allenrobberson/smart-sensor-battery-pack/README.md

# Smart Sensor Battery Pack (18350 / 18650 / 21700 / universal)

A small battery board for a Seeed XIAO microcontroller and an SHTC3 temperature and humidity sensor, for building wireless sensors that run on a single lithium-ion cell. The XIAO plugs into sockets on the front, and the cell sits in a holder on the back.

This is a fork of [FeatureNAB/smart-sensor-battery-pack](https://github.com/FeatureNAB/smart-sensor-battery-pack). It adds two larger battery sizes (18650 and 21700), a **universal board** that takes any of the three holders, a few protection and power improvements, and ready-to-use ESPHome firmware for Home Assistant. All the boards share the same circuit and front-side layout. The full list of changes is under [Changes from the original design](#changes-from-the-original-design).

**Downloads:** each board option (18350, 18650, 21700, universal) comes as one zip on the [Releases page](https://github.com/allenrobberson/smart-sensor-battery-pack/releases). Each zip has the Gerbers, the JLCPCB BOM and placement files, the case STLs, the firmware and a KiCad project that opens on its own.

> **U6 rotation fix (12 November 2026):** placement (CPL) files downloaded before this date have U6 (CSD85301Q2) at 180°; the correct angle is 90°. Use the v1.0 release files. If you already ordered with the old files, ask JLCPCB to rotate U6 to 90° (see [the rotation note](#assembled-by-jlcpcb-bom-and-placement-files)).

The original design, with the build, design theory and assembly, is explained in this video:

Watch the video (https://www.youtube.com/watch?v=-wEKOhVZ0NM)

## Thank you
A big thank you to **FeatureNAB** for designing this board and sharing it openly, along with the video that explains how and why it works. The charging, protection and sensor-isolation design, the compact layout, and the KiCad project are all their work. This fork only builds on that foundation. If you find this useful, please watch and support the [original video](https://www.youtube.com/watch?v=-wEKOhVZ0NM) and [repository](https://github.com/FeatureNAB/smart-sensor-battery-pack).

## Changes from the original design
**New board sizes**
- **18650 board** (`variants/18650/`): Keystone 1042 holder, 23 x 86.25 mm.
- **21700 board** (`variants/21700/`): Keystone 1121 holder (also fits 20700), 24 x 84.55 mm.
- **Universal board** (`variants/universal/`): one 24 x 86.25 mm board with pads and peg holes for the 1096, 1042 *or* 1121 holder, so one design covers 18350, 18650 and 21700. See [Universal](#universal-18350-18650-and-21700-on-one-board).
- **3D-printable case** (`case/`): a base and lid for every board size, including the universal board, with a USB-C window, sensor vents and wall-mount tabs. See [3D-printable case](#3d-printable-case).
- **Variant generator** (`tools/make_variant.py`): rebuilds the larger boards from the 18350 master after any change, swaps the holder, resizes the outline and checks that the holder's holes clear existing copper.

**Circuit changes (all boards)**

| Part | Original | This fork | Why |
|---|---|---|-----|
| Q2 (new) | — | AO3401A P-MOSFET in the battery + line | Protects everything if the cell is inserted backwards |
| U4 regulator | TPS7A05 (200 mA) | RT9080-33GJ5 (600 mA, 2 µA quiescent) | The ESP32-C6 draws up to 354 mA when Wi-Fi transmits; same footprint and pinout |
| C3 (3.3 V cap) | 2.2 µF | 10 µF | Absorbs Wi-Fi current bursts |
| R2 (charger TS) | 10 kΩ fixed resistor | 10 kΩ NTC thermistor, moved away from the charger | Stops charging when too cold or hot; the fixed resistor disabled this |
| R1 (charge current) | 1.2 kΩ (450 mA) | 18350: unchanged. 18650 and 21700: 910 Ω (about 590 mA). Universal: 1 kΩ (about 540 mA) | Larger cells finish charging inside the charger's 10-hour safety timer |
| U1 (schematic) | XIAO nRF52840 | XIAO ESP32-C6 | Matches the firmware; the sockets are the same |

The 18350 board keeps its original size and front layout; Q2 and the moved thermistor fit in free space in the top-right corner.

**Firmware and Home Assistant (new)**
- **ESPHome config** for the XIAO ESP32-C6 (`firmware/`) with deep sleep, sensor power sequencing, internal I2C pull-ups disabled and pins released before sleep, so the sensor is never powered through its data lines.
- **Home Assistant package** (`homeassistant/`) adding a "stay awake" toggle for over-the-air updates, plus a secrets template.

**Manufacturing files (new)**
- **Gerber zips** for all four boards (18350, 18650, 21700, universal) in `gerbers/`, generated by `tools/make_gerbers.py` and checked for shorts and broken connections.
- **JLCPCB assembly files** (BOM with LCSC part numbers, and placement files) in `assembly/`; the schematics now carry LCSC numbers for the new parts.

**Documentation**
- **I2C note corrected:** the original note said pull-ups were missing. R9 and R10 are already in the design, on the switched sensor rail.
- **Points from the original project's [issue #1](https://github.com/FeatureNAB/smart-sensor-battery-pack/issues/1) ("Missing Pull Up Resistor"):**
  - *Pull-ups on the switched rail (3V_SW) vs. 3V3:* kept on 3V_SW on purpose. Pull-ups on the always-on 3V3 would push current into the SHTC3 through SDA/SCL while its supply is off (phantom powering). On 3V_SW, the pull-ups and the sensor are switched on and off together.
  - *"The sensor has to be powered before the bus starts":* the firmware switches the sensor rail on at boot priority 1200, before I2C sets up (priority 1000), and waits 5 ms so the sensors are ready. No extra YAML is needed.
  - *"Use the internal pull-ups instead":* not used. The ESP32-C6's internal pull-ups are about 45 kΩ, too weak to be reliable, and they would phantom-power the sensor during sleep. They are disabled.
  - *Pull-up current:* none while the bus is idle (I2C is open-drain), and none at all while the rail is off.
  - *Measured 380 µA asleep and a 3.45 s wake:* the firmware now sleeps 2 s after Home Assistant connects instead of staying awake a fixed 20 s, so a typical wake is about 3–6 s and uses roughly a quarter of the energy. See [Sleep current](#sleep-current) for how to measure.
  - *Static IP slower for one tester:* the config now says to measure before relying on a static IP.
  - *Edge.Cuts DRC errors:* the outlines of all three boards here are closed (checked: no open ends).
  - *Larger + / − battery marks:* the holder footprints have small + and − marks on the back silkscreen. Reverse-battery protection (Q2) also protects the board if a cell goes in backwards.
- **README rewritten:** board descriptions, comparison images, setup steps and known limitations.

## Quick start
Here's everything you need to build one, in order:

1. **Pick a board:** 18350 (smallest), 18650 or 21700 (longest runtime), or the universal board if you want to choose the cell later. See [The board designs](#the-board-designs).
2. **Order the board:** upload that board's Gerber zip from [`gerbers/`](gerbers) to JLCPCB. Optionally add assembly with the matching BOM and placement files from [`assembly/`](assembly); see [Ordering boards](#ordering-boards-gerber-files).
3. **Buy the parts that aren't on the board order:**
   - The **battery holder** for your size, from DigiKey (see [Battery holders](#battery-holders)).
   - A **Seeed XIAO ESP32-C6** ([product wiki](https://wiki.seeedstudio.com/xiao_esp32c6_getting_started)).
   - A **lithium-ion cell** (see [Batteries](#batteries)).
4. **Solder the holder, then check the board** before inserting a cell (see [Assembly and first power-up](#assembly-and-first-power-up)).
5. **Flash the firmware and add the sensor to Home Assistant** (see [Firmware](#firmware-esphome-xiao-esp32-c6)).
6. **Optionally plug in a second sensor** (see [Adding other sensors](#adding-other-sensors)).

## What the board does
- **Microcontroller:** made for a Seeed **XIAO ESP32-C6**. The board uses D2 (GPIO2) for battery voltage, D4/D5 (GPIO22/23) for I2C and D10 (GPIO18) to switch the sensor power.
- **Charging:** a BQ21040 charges the cell from the XIAO's USB 5 V, and an LED shows charge status. R1 sets the charge current: 450 mA on the 18350 board and about 590 mA on the 18650 and 21700 boards, so a full charge fits inside the charger's 10-hour safety timer.
- **Battery temperature:** a 10 kΩ NTC thermistor (R2, Murata NCP15XH103F03RC) on the charger's TS pin stops charging when the board is too cold or too hot for lithium-ion. It sits in the corner furthest from the charger so the charger's own heat doesn't trip it.
- **Reverse-battery protection:** a P-channel MOSFET (Q2, AO3401A) in series with the cell's + terminal, with its gate on the cell's − terminal. A correctly inserted cell turns it fully on in both directions, for charging and discharging. A reversed cell leaves it off, and its body diode blocks the current.
- **Cell protection:** a BQ29700 protector with a CSD85301Q2 dual MOSFET guards against over-charge, over-discharge and over-current.
- **Power:** an RT9080-33GJ5 regulator (600 mA, 2 µA quiescent current) supplies 3.3 V to the XIAO. That covers the ESP32-C6's Wi-Fi transmit peaks (up to 354 mA at full power) with headroom, and a 10 µF capacitor (C3) on 3.3 V absorbs the bursts.
- **Battery monitoring:** a 5.1 MΩ / 5.1 MΩ divider brings the battery voltage to a XIAO analog pin (BATT_SENSE) and draws about 0.4 µA.
- **Switched sensor power:** a P-channel MOSFET (Q1, AO3401A) lets the XIAO turn the sensor rail (3V_SW) off between readings. The I2C pull-ups (R9, R10) are on that rail too, so nothing on the sensor side draws current while the XIAO sleeps.
- **Sensor:** an SHTC3 sits on a slotted tab at the bottom edge, thermally isolated from the rest of the board, with an extra socket for a plug-in I2C sensor.

## The board designs
All the boards share the same schematic and the same front-side parts and routing. Only the holder on the back, the board outline and the two battery traces change. The extra length is added at the BAT+ end, so the sensor tab stays where it is.

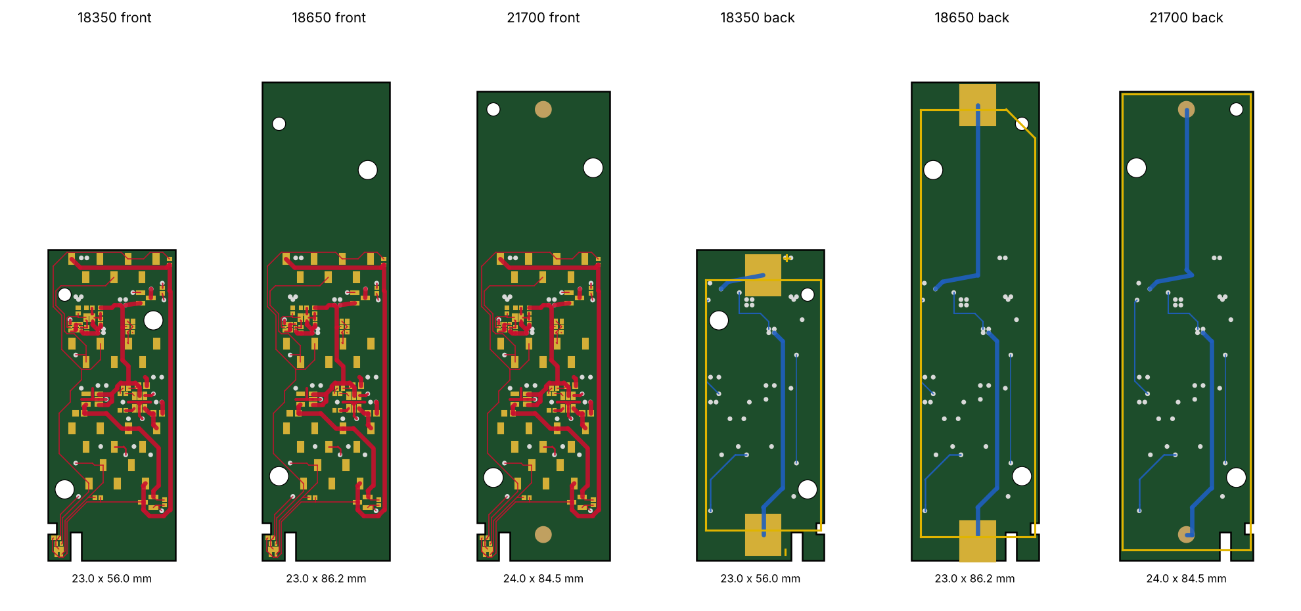
[picture p1: docs/images/board_comparison.png]
All three boards, front and back


| Cell | Holder (back side) | Holder mounting | Board size | KiCad project |
|---|---|---|---|---|
| 18350 | Keystone 1096 | Surface mount | 23 x 56 mm | repository root (original design) |
| 18650 | Keystone 1042 | Surface mount | 23 x 86.25 mm | `variants/18650/` |
| 21700 | Keystone 1121 (fits 20700 and 21700) | Through-hole solder lugs | 24 x 84.55 mm | `variants/21700/` |
| **Universal** | Keystone 1096, 1042 **or** 1121 | SMD pads + lug holes for all three | 24 x 86.25 mm | `variants/universal/` |

### 18350
The original, most compact design. The Keystone 1096 holder covers the whole back of the board.

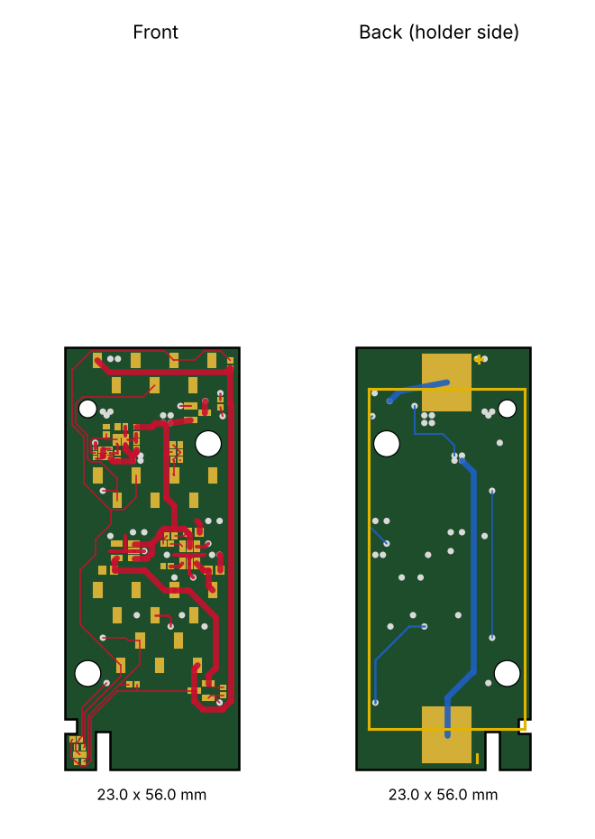
[picture p2: docs/images/board_18350.png]
18350 board, front and back


### 18650
The same board stretched to 86.25 mm for a Keystone 1042 holder. The holder's locating holes are placed to clear all existing copper. The BAT- pad overhangs the bottom edge by 0.25 mm, which DRC will flag; the original board overhangs its BAT+ pad by 0.95 mm in the same way.

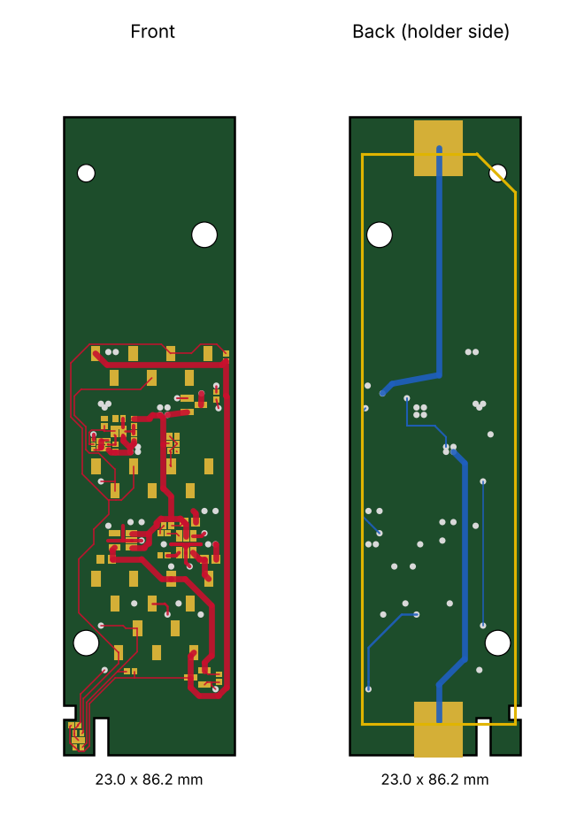
[picture p3: docs/images/board_18650.png]
18650 board, front and back


### 21700
Uses a Keystone 1121 holder. The holder is 23.06 mm wide, so the board is 1 mm wider than the original, with the extra width on the right so the sensor tab is unchanged. The holder's solder lugs go through the board and are soldered from the front.

The footprint was drawn from Keystone drawing 1121 rev A. The lug holes are drilled 1.7 mm instead of the drawing's 1.32 mm, because the drawing gives the lug pin itself as 1.57 mm. Check a lug against the hole before ordering.

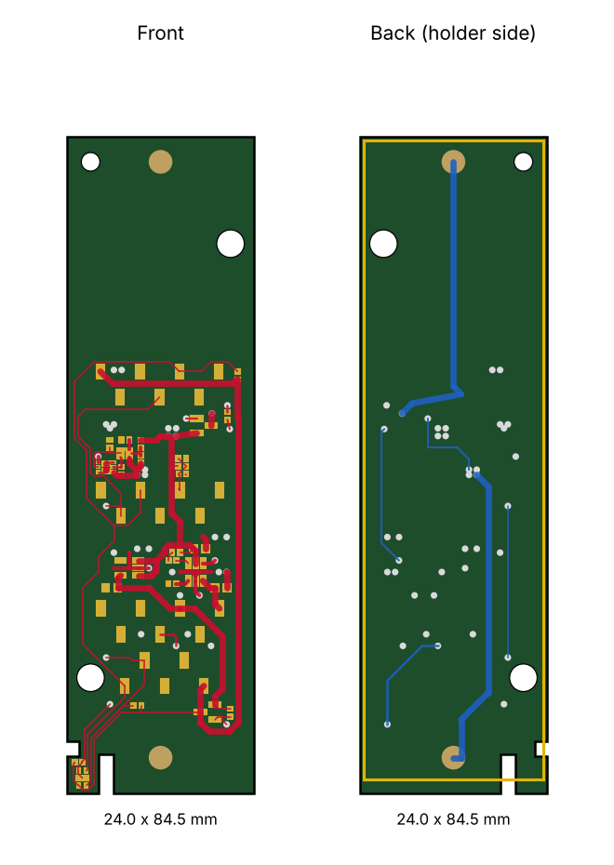
[picture p4: docs/images/board_21700.png]
21700 board, front and back


### Universal (18350, 18650 and 21700 on one board)
One board that takes any of the three holders, so you can order a single design and choose the cell later. It is the 21700 board lengthened to 86.25 mm (the 1042's length), 24 mm wide.

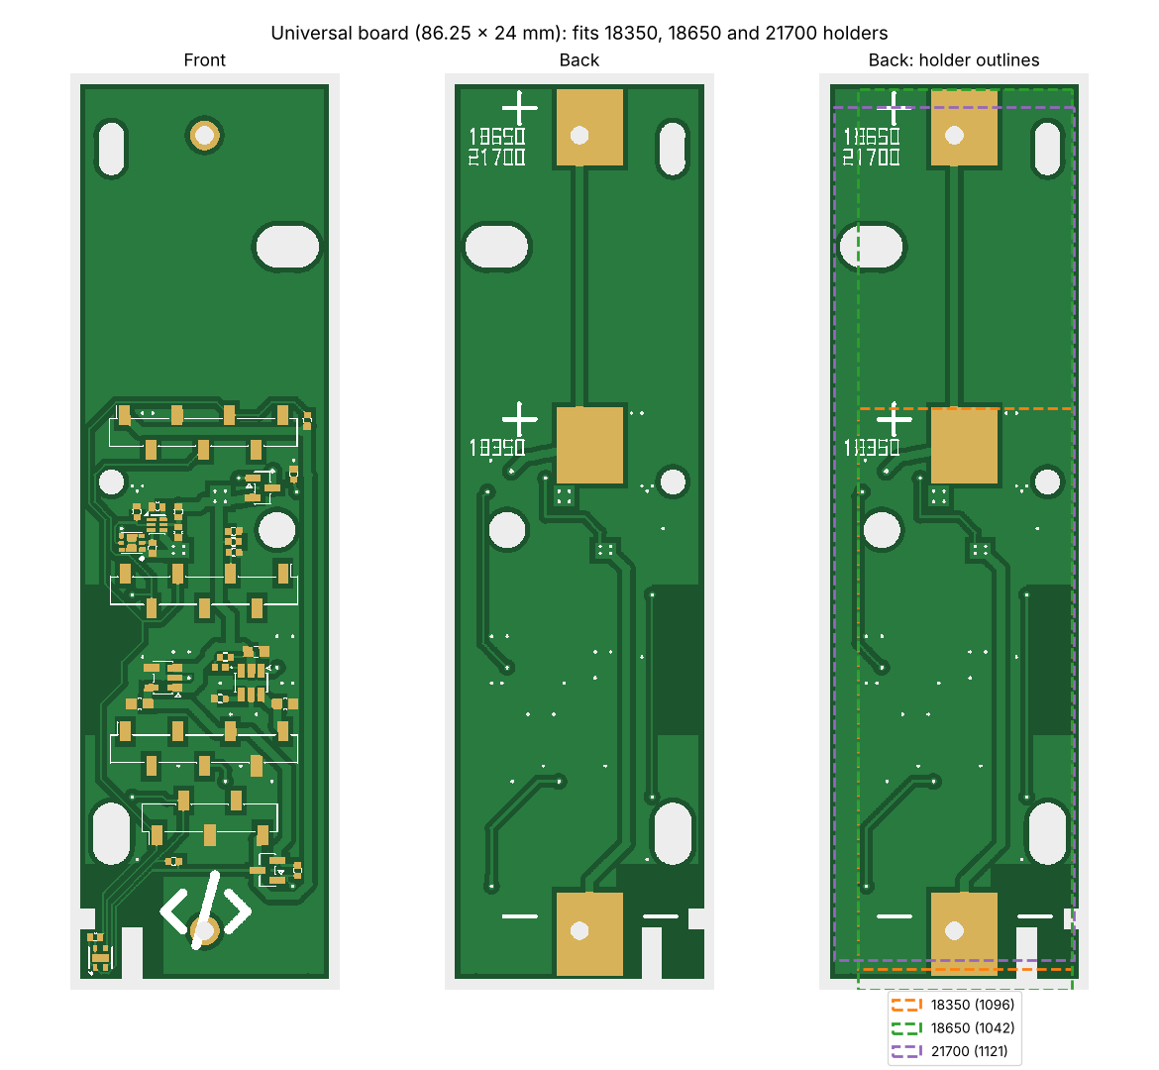
[picture p5: docs/images/board_universal.png]
Universal board: front, back, and where each holder sits


- **BAT- end (bottom):** one larger SMD pad covers both the 1096 and the 1042 contact, with the 1121's plated lug hole in the middle of it. All three holders' − contacts land here.
- **BAT+ end (top):** the + pad for the 1042 (18650) sits at the top edge, with the 1121's (21700) lug hole inside it. A second + pad for the 1096 (18350) sits 30.7 mm further down. The two are joined by the BAT+ trace on the back, under solder mask, so there is no long strip of bare battery copper. The back silkscreen shows which + pad belongs to which cell (`18650 21700` and `18350`), plus large + and − marks.
- **Locating holes:** every holder's pegs have a hole. Where two holders' pegs overlap, the holes are merged into slots: one small and one large slot on the left, and one large slot on the right. All holes keep at least 0.3 mm from copper.
- **Charge current:** R1 is **1 kΩ (about 540 mA)**, LCSC C11702, a basic part. That's under 0.5C for a 1100 mAh 18350 and still charges a 4500 mAh 21700 inside the charger's 10-hour safety timer. With a 5000 mAh cell charged from empty, the timer can stop the charge just before it finishes; unplugging and replugging USB restarts it. For an 18650/21700-only build, you can fit 910 Ω (C44933) instead.
- **Soldering the holder:** for the 1096 or 1042, solder the contacts to the pads; the small lug holes under them just fill with solder. For the 1121, solder its lugs from the front as on the 21700 board. Only fit one holder.

The front side, parts and routing are the same as the other three boards, so the same firmware and BOM apply. The only BOM difference is R1. The board and its files were made by `tools/make_universal.py`.

**What has been checked:** the Gerbers have no shorts or broken nets; every hole and slot keeps at least 0.3 mm from other-net copper; no copper is within 0.25 mm of the board edge; JLCPCB accepted the files, matched all 19 parts and showed the slots correctly; and every part's rotation was checked in JLCPCB's placement preview (pin-1 marks and leads on pads). **Not yet checked:** a KiCad DRC run (open `variants/universal/` in KiCad, press B to refill zones, then run DRC) and a physical test-fit of each holder. Check the peg slots against a real holder before ordering in quantity.

## 3D-printable case
A two-part case (base + lid) for every board, in [`case/stl/`](case/stl). Details and print settings are in [`case/README.md`](case/README.md).

| Board | Print |
|---|---|
| 18350 | [`case-18350-base.stl`](case/stl/case-18350-base.stl) + [`case-18350-lid.stl`](case/stl/case-18350-lid.stl) |
| 18650 | [`case-18650-base.stl`](case/stl/case-18650-base.stl) + [`case-18650-lid.stl`](case/stl/case-18650-lid.stl) |
| 21700 | [`case-21700-base.stl`](case/stl/case-21700-base.stl) + [`case-21700-lid.stl`](case/stl/case-21700-lid.stl) |
| Universal | the base for the holder you fitted ([`18350`](case/stl/case-universal-18350-base.stl), [`18650`](case/stl/case-universal-18650-base.stl) or [`21700`](case/stl/case-universal-21700-base.stl)) + [`case-universal-lid.stl`](case/stl/case-universal-lid.stl) |

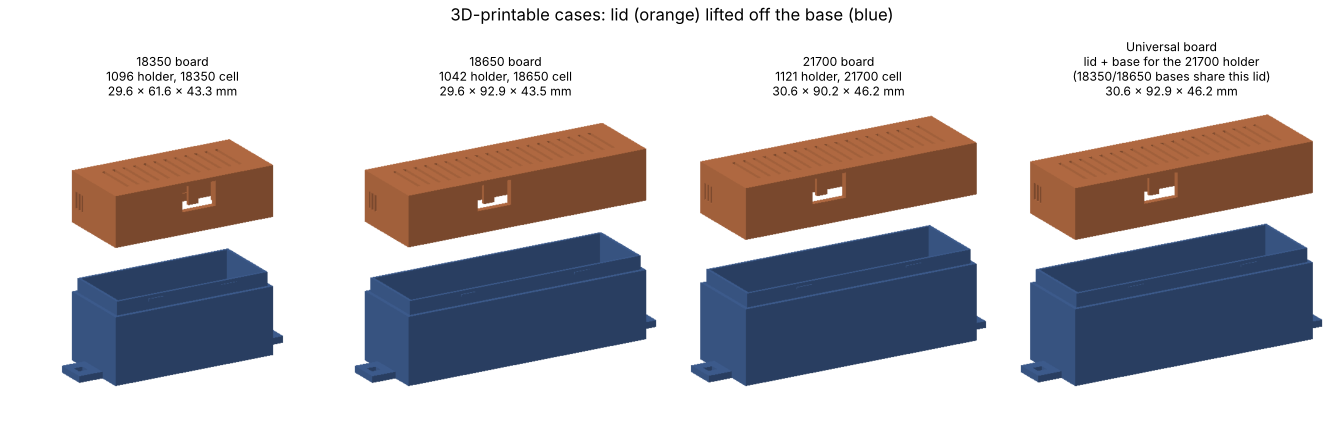
[picture p6: case/images/cases-overview.png]
All four cases, lid lifted off the base


More views of each case (exploded, base, lid from below, assembled) and cut-away fit checks are in [`case/images/`](case/images).

- **Base:** the board drops in battery-side down and rests on ribs under the holder's end walls.
- **Lid:** clicks onto a lip on the base; small fingers stop just above the board's edges so it can't move.
- **USB-C window:** lined up with the XIAO's USB-C port, so you can charge and flash without opening the case.
- **Vents** next to the SHTC3 sensor tab and across the roof, so the sensor reads room air; **wall-mount tabs** on both ends.
- **Checked:** the generator checks every case against the board, holder, cell, every part, the XIAO and the USB-C plug path, and checks that the STLs are watertight. The case hasn't been test-printed yet. If your sockets or headers are a different height, change the values at the top of [`tools/make_case.py`](tools/make_case.py) and run it again.

## Ordering boards (Gerber files)
Ready-to-upload Gerber zips for all four boards are in [`gerbers/`](gerbers):

| Board | File | Size |
|---|---|---|
| 18350 | [`gerbers/SSB-18350-gerbers.zip`](gerbers/SSB-18350-gerbers.zip) | 23 x 56 mm |
| 18650 | [`gerbers/SSB-18650-gerbers.zip`](gerbers/SSB-18650-gerbers.zip) | 23 x 86.25 mm |
| 21700 | [`gerbers/SSB-21700-gerbers.zip`](gerbers/SSB-21700-gerbers.zip) | 24 x 84.55 mm |
| Universal | [`gerbers/SSB-UNIVERSAL-gerbers.zip`](gerbers/SSB-UNIVERSAL-gerbers.zip) | 24 x 86.25 mm |

**To order at JLCPCB:** upload a zip on the quote page and keep the defaults: 2 layers, 1.6 mm FR-4, 1 oz copper. Choose any solder-mask colour. If you want JLCPCB to assemble the parts, pick **LeadFree HASL** so the cheaper Economic assembly is allowed (see [Tested JLCPCB order settings](#tested-jlcpcb-order-settings-november-2026)). Each zip holds both copper layers, solder mask, paste, silkscreen, the board outline, and plated and non-plated drill files.

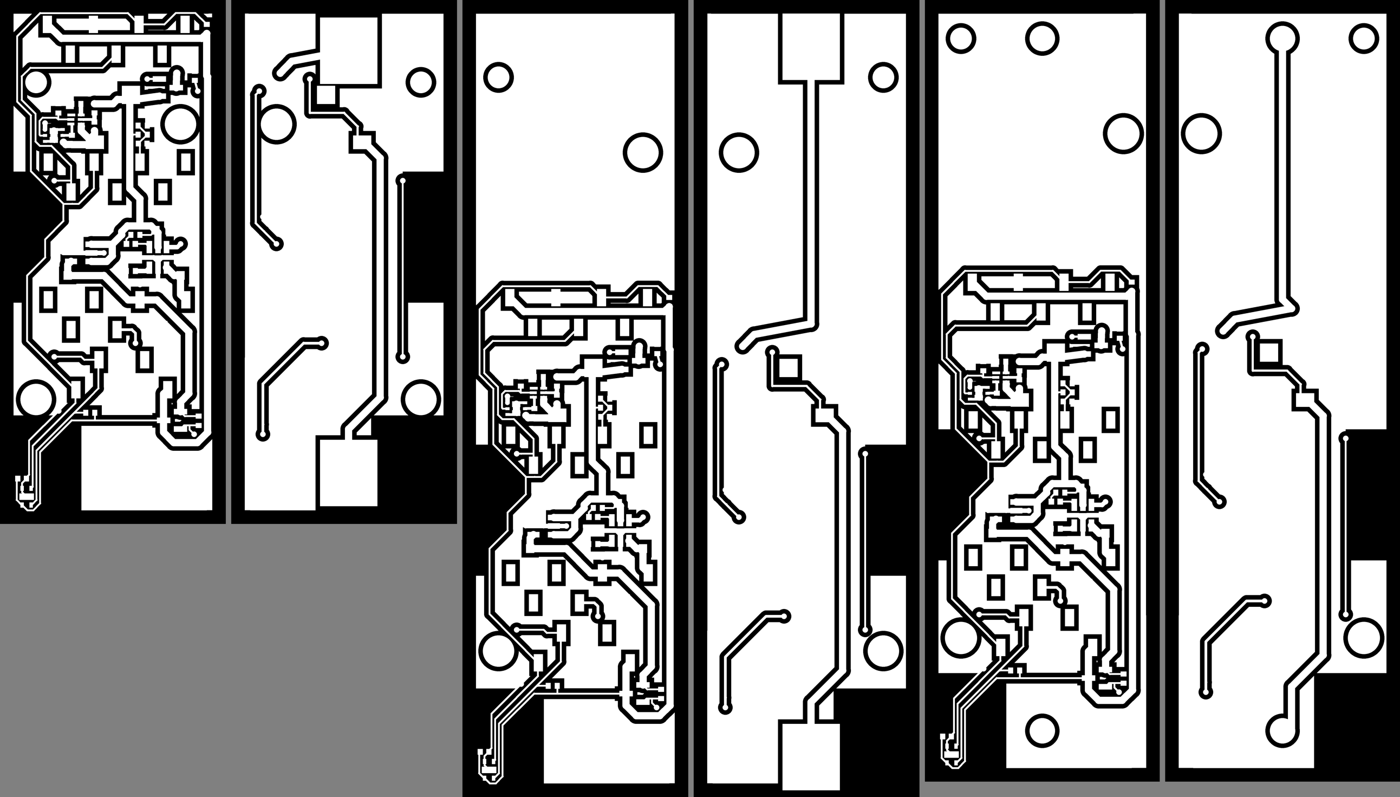
[picture p7: docs/images/gerber_copper.png]
Copper layers of all three boards


*Copper as written to the Gerbers (white = copper), front and back for 18350, 18650 and 21700. The back views are mirrored as if the board were flipped over.*

### Assembled by JLCPCB (BOM and placement files)
To have JLCPCB solder the parts, choose **PCB Assembly** (top side) on the quote page, then upload the BOM and placement (CPL) files for the same board from [`assembly/`](assembly):

| Board | BOM | Placement |
|---|-----|---|
| 18350 | [`SSB-18350-BOM.csv`](assembly/SSB-18350-BOM.csv) | [`SSB-18350-CPL.csv`](assembly/SSB-18350-CPL.csv) |
| 18650 | [`SSB-18650-BOM.csv`](assembly/SSB-18650-BOM.csv) | [`SSB-18650-CPL.csv`](assembly/SSB-18650-CPL.csv) |
| 21700 | [`SSB-21700-BOM.csv`](assembly/SSB-21700-BOM.csv) | [`SSB-21700-CPL.csv`](assembly/SSB-21700-CPL.csv) |
| Universal | [`SSB-UNIVERSAL-BOM.csv`](assembly/SSB-UNIVERSAL-BOM.csv) | [`SSB-UNIVERSAL-CPL.csv`](assembly/SSB-UNIVERSAL-CPL.csv) |

Every part except the battery holder uses a JLCPCB/LCSC part number:

| Part | Designator | LCSC # |
|---|---|---|
| Charger BQ21040DBVR | U2 | C202311 |
| Protector BQ29700DSER | U5 | C183096 |
| Dual MOSFET CSD85301Q2 | U6 | C544396 |
| Regulator RT9080-33GJ5 | U4 | C841192 |
| P-MOSFET AO3401A | Q1, Q2 | C15127 |
| SHTC3 sensor | U7 | C194656 |
| 10 kΩ NTC (Murata NCP15XH103F03RC) | R2 | C77131 |
| 10 µF 0603 | C3 | C19702 (basic part) |
| 2.2 µF 0603 | C1, C2 | C23630 (basic part) |
| 100 nF 0402 | C4, C5, C6 | C1525 |
| Charge-current resistor | R1 | 1.2 kΩ C25862 (18350), 910 Ω C44933 (18650, 21700) |
| Other 0402 resistors, LED | R3–R12, D1 | see the BOM files |
| XIAO sockets 1x7 / 1x5 SMD | J1, J2, J3 / J5 | C42379199 / C42379198 |

Things to know before ordering assembly:
- **Battery holder:** BT1 is not in the BOM, so buy it separately and solder it yourself (see [Battery holders](#battery-holders) below).
- **Extended parts:** most of the ICs are JLCPCB "extended" parts, which carry a small one-time loading fee each. Stock changes, so the quote page will flag anything that has run out.
- **Rotations are already corrected:** the CPL files include JLCPCB's zero-angle offsets for the sockets, SOT-23, SOT-23-5, SOT-23-6, SHTC3 and CSD85301Q2 parts (see `ROTATION_FIX` in `tools/make_jlc_bom.py`). Every part was checked in JLCPCB's placement preview: each IC's pin-1 marker sits at the board's pin-1 mark and its leads on the pads. All four boards share identical front-side pads and placement data, so the check covers all of them. **U6 (CSD85301Q2) needs 90°, not 180°:** JLCPCB's library footprint for C544396 has the pins in rows with pin 1 bottom-left, while the KiCad footprint has them in columns. The first CPL files (used for the November 2026 order of the 18350/18650/21700 boards) had U6 at 180°, which turns the part 90° on its pads. This was fixed on 12 November 2026; if you downloaded the assembly files before then, download them again. **If you already placed an order with the old CPL file,** message JLCPCB (through the order's File Review or support chat) before assembly and ask them to place U6 (CSD85301Q2, C544396) at 90° so that pin 1 sits at the silkscreen dot. They can correct the rotation on an order that is still in review.
- **The XIAO:** it plugs into the sockets and isn't part of the order.

#### Tested JLCPCB order settings (November 2026)
The 18350, 18650 and 21700 Gerbers and BOMs are exactly the ones uploaded for a real order of those three boards. Their CPL (placement) files have since had one fix: U6 is now at 90° instead of 180° (see the rotation note above). The universal board's files were uploaded with the same settings and quoted at **$73.82** for 5 assembled boards ($5.10 PCB + $68.72 assembly, including $0.91 nitrogen reflow); all 19 parts matched and were in stock, and JLCPCB's preview showed its slotted holes correctly. These settings went through without errors:

| Setting | Value | Why |
|---|---|-----|
| Surface finish | **LeadFree HASL** | Economic PCBA does not accept OSP. Lead-free HASL costs about $1.10 more, but it unlocks the much cheaper assembly tier |
| PCBA type | **Economic** | Setup fee about $8 instead of about $26, a $1.55 stencil instead of $8.27, and no per-feeder loading fees (only a ~$3 fee per extended part) |
| PCB qty / PCBA qty | 5 / 5 | Economic PCBA allows 2 to 50 assembled boards |
| Assembly side | Top | BT1 on the back is soldered by hand |
| Tooling holes | Added by JLCPCB | Default |
| Product description | Sensor\Controller\Precision Instrument / Temperature Sensor | Needed for customs |
| Assembly remark | (optional) "Please confirm pin 1 of U6 (CSD85301Q2, C544396) is at the silkscreen dot, bottom-right of U6." | A second check on the one part whose rotation had to be corrected. The **Assembly Remark** box doesn't always appear; if it's missing, raise it during **File Review** in your order history. Don't use the 200-character **PCB Remark** box, which goes to the board factory, not assembly. |

Quoted price for 5 assembled boards, before shipping and coupons:

| Board | PCB | Assembly (Economic) | Total |
|---|-----|---|---|
| 18350 | $5.10 | $68.74 | **$73.84** |
| 18650 | $5.10 | $71.84 | **$76.94** |
| 21700 | $5.10 | $71.84 | **$76.94** |

Assembly breakdown (Economic PCBA, 5 boards):

| Item | 18350 | 18650 | 21700 |
|---|---|---|---|
| Setup fee | $8.24 | $8.24 | $8.24 |
| Stencil | $1.55 | $1.55 | $1.55 |
| Components (19 BOM lines) | $26.09 | $26.10 | $26.10 |
| Extended components fee | $30.90 | $33.99 | $33.99 |
| SMT assembly | $1.05 | $1.05 | $1.05 |
| Nitrogen reflow | $0.91 | $0.91 | $0.91 |
| **Assembly total** | **$68.74** | **$71.84** | **$71.84** |
| PCB (5 boards, lead-free HASL) | $5.10 | $5.10 | $5.10 |
| **Per order** | **$73.84** | **$76.94** | **$76.94** |
| **Per assembled board** | **$14.77** | **$15.39** | **$15.39** |

Universal board (quoted the same way): $5.10 PCB + $68.72 assembly = **$73.82** for 5 assembled boards ($14.76 each), the same extended-part fees as the 18350.

The 18350 has one fewer extended part than the other two (its R1, C25862, is a basic part), so its fee is lower.

All three boards in one checkout (15 assembled boards), as actually ordered and shipped to the US in November 2026:

| | Cost |
|---|---|
| Merchandise (3 × PCB + PCBA) | $227.72 |
| Shipping (the cart page had estimated $31.69 for UPS Express Saver) | $64.13 |
| US customs duties and taxes | $79.73 |
| Duty and tax disbursement fee | $4.44 |
| **Order total** | **$376.02** (about $25 per assembled board) |

**Budget for more than the cart shows.** The cart's shipping estimate is only a starting point: the shipping charge depends on the method you choose at checkout. US import duties and taxes on the assembled boards came to about 35% of the merchandise total, and JLCPCB charges them at checkout (DDP). Coupons (below) come off the total. Ordering fewer board sizes lowers every line, since each design is a separate PCB + PCBA order.

Not included: the battery holder (BT1, bought separately, see [Battery holders](#battery-holders)), the XIAO ESP32-C6 and the battery.

**Coupons:** JLCPCB uses account coupons rather than codes, and you choose them in the payment step of checkout. New accounts get New User SMT ($10), PCB ($6) and Shipping ($10) coupons, and the [coupon center](https://jlcpcb.com/coupon-center) has more (for example, "PCBA Special Offer" $9/$6). Checking out in the **JLCONE desktop app** unlocks a "JLCONE PCBA $20" coupon for assembly orders over $100, which beats the $10 one for a three-board order. JLCPCB's terms allow one coupon per order, so the checkout page has the final say. Check out all three boards together: separate orders each pay their own shipping (about $27), which costs more than the extra coupons save.

For comparison, the same 18350 order as *Standard* PCBA on OSP came to $96.33.

**Ways to cut the cost further:**
- **Order 2 assembled boards instead of 5.** Most of the assembly cost is per-order fees (setup, extended-part fees), so 2 boards cost only a little less than 5, but the total is still lower if you only need one or two.
- **Order one or two sizes, not all three.** Each design pays its own setup and extended-part fees.
- **Solder the XIAO sockets yourself.** J1–J3 and J5 (C42379199, C42379198) cost about $5.65 in parts per 5-board order, plus two extended-part fees (about $6). Untick them on the BOM page and solder ordinary 2.54 mm female headers.
- **Drop the status LED.** D1 (and its resistor R8) are optional. Unticking D1 saves one extended-part fee.
- **Basic parts were preferred** where they did not change the circuit: R7 (100 kΩ) uses basic part C25741.
- **Order only the universal board** if you haven't decided on a cell size: one design covers all three holders, so you pay one set of setup and extended-part fees.

**Part changes made while ordering:**
- **R1 on the 18650/21700:** C4129882 (910 Ω, 5%) was out of stock, so R1 is now Uniroyal 0402WGF9100TCE, **C44933** (910 Ω, 1%, about 228k in stock). The value and charge current (about 590 mA) are unchanged.
- **R7, all boards:** now C25741 (basic, 1%) instead of C25530 (extended, 5%). Same 100 kΩ value.

### Battery holders
**Note:** the battery holder is the one part JLCPCB does not assemble. It isn't in the BOM, because JLCPCB doesn't reliably stock these Keystone holders and they mount on the back of the board, which would need a second, more expensive assembly side. Order the holder for your board size and solder it yourself after the boards arrive.

Each board is laid out for one specific Keystone holder, and only that part fits its pads and locating holes:

| Board | Holder | Mounting | DigiKey |
|---|---|---|-----|
| 18350 | Keystone **1096** | Surface mount (tabs soldered on the back) | [36-1096-ND](https://www.digikey.com/en/products/detail/keystone-electronics/1096/5057788) |
| 18650 | Keystone **1042** | Surface mount (tabs soldered on the back) | [36-1042-ND](https://www.digikey.com/en/products/detail/keystone-electronics/1042/2745668) |
| 21700 | Keystone **1121** (fits 20700 and 21700) | Through-hole lugs (soldered from the front) | [36-1121-ND](https://www.digikey.com/en/products/detail/keystone-electronics/1121/12751670) |

**Soldering tips**
- **1096 and 1042:** the holder sits on the back. Tack one tab, check the holder is flat with its locating pegs in the holes, then solder the other tab. The tabs are large, so use a hot iron (about 350 °C) and plenty of flux.
- **1121:** push the lugs and pegs through from the back, then solder the two lugs on the front.
- **Polarity:** check it before inserting a cell. The + end of the holder must match the + mark on the board (the BAT+ end, away from the sensor tab). Q2 protects the board if a cell goes in backwards, but double-check anyway.

The files come from [`tools/make_jlc_bom.py`](tools/make_jlc_bom.py), which reads the *LCSC Part no.* field from each schematic and the positions from the board, in the same coordinates as the Gerbers.

**How these were made:** KiCad was not available, so the files were generated by [`tools/make_gerbers.py`](tools/make_gerbers.py) directly from the `.kicad_pcb` files. It fills the copper pours itself: ground copper everywhere, a 0.5 mm gap around every other net and the board edge, and no copper in the keep-out areas. Every copper layer was then rasterized at 0.02 mm and checked automatically. There are no shorts between nets, no broken connections, and every pad, via and trace sits on copper. The check was itself tested by deliberately breaking a trace, which it caught. The differences from a KiCad export are:
- **Solid ground connections:** pads and vias on the ground pour are joined solidly rather than through thermal-relief spokes. Ground pads take a little longer to heat when hand-soldering.
- **Square pad corners:** rounded-rectangle pads are drawn as plain rectangles.
- **Outline-only silkscreen:** part outlines are drawn, but there's no text (reference designators and the logo). Use the board images above while assembling.

If you have KiCad 9, the safer route is still to open each project, press **B** to refill the zones, run DRC, and plot your own Gerbers. To regenerate these files after a design change, run:
```
python3 tools/make_gerbers.py <board.kicad_pcb> <output_dir> --name <prefix>
```

## Before ordering boards
The design changes in this fork (reverse-battery transistor, NTC, new regulator, larger boards) were made by script. They were checked with the clearance, connectivity and Gerber checks described above, but not with KiCad's own DRC, and no board has been built yet. Order a small batch first.

### Known limitations
- **Cell temperature is measured on the board, not on the cell.** The thermistor sits on the front, above the cell, so it reads board temperature. Charging can pause on a hot day once the board passes about 45 °C.
- **A completely flat cell (near 0 V) won't charge.** Q2 needs a couple of volts across the cell to turn on. Cells that low shouldn't be recovered anyway.
- **USB plugged in with a nearly empty cell.** When the XIAO runs from USB, its own regulator also drives 3.3 V. If the cell is below about 3.0 V at that moment, the RT9080's output sits slightly above its input, past its 0.3 V reverse rating. The original design had the same behaviour; it lasts only until the cell charges past 3 V.

## Connectors and pinout
The XIAO plugs into J1 and J2. J3 and J5 are for an optional plug-in sensor.

| Socket | Pin 1 | Pin 2 | Pin 3 | Pin 4 | Pin 5 | Pin 6 | Pin 7 |
|---|---|---|---|---|---|---|---|
| **J1** (XIAO left row) | D0 – free | D1 – free | D2 – BATT_SENSE | D3 – free | D4 – SDA | D5 – SCL | D6 – free |
| **J2** (XIAO right row) | D7 – free | D8 – free | D9 – free | D10 – sensor power (Q1) | 3V3 | GND | 5V (USB) |
| **J3** (sensor socket, top edge) | 3V3 switched | not connected | GND | SCL | SDA | not connected | not connected |
| **J5** (sensor socket, middle) | SDA | SCL | GND | not connected | 3V3 switched |  |  |

- **Switched 3.3 V:** this rail on J3 and J5 is the sensor rail controlled by Q1. It's only powered while the firmware holds D10 (GPIO18) low, so a plug-in sensor is switched off during deep sleep, just like the onboard SHTC3.
- **J3's pin order** (power, unused, GND, SCL, SDA) is the common breakout header order *VIN, 3Vo, GND, SCL, SDA*, so many 5-pin breakouts plug straight in. Always check the header order printed on your breakout first.
- **Free XIAO pins:** D0, D1, D3, D6, D7, D8 and D9 aren't connected to anything on the board, so you can use them for your own additions.

## Batteries
- **Cell type:** use a single **3.7 V lithium-ion cell** of the size your board is built for (18350, 18650, or 20700/21700; on the universal board, the size of the holder you fitted). The board has its own protection (BQ29700) and reverse-battery protection (Q2), so unprotected cells are fine.
- **Cell length:** protected cells are a few millimetres longer and may not fit the holder.
- **Cell source:** buy from a reputable cell manufacturer or a known battery retailer. Avoid unbranded cells with inflated capacity ratings.
- **Charge time:** about 3 hours for a typical 18350, 6–8 hours for an 18650 and up to about 9 hours for a 5000 mAh 21700. The charger's 10-hour safety timer covers all of these.
- **Polarity:** match the cell's + end to the + mark on the holder. Q2 protects the board if a cell goes in backwards, but the cell won't charge or run the board until it's turned around.

## Assembly and first power-up
1. **Solder the board:** solder the battery holder, and anything else you didn't have assembled. The [BOM files](assembly) list every part with its LCSC number, so you can also order them from LCSC and hand-solder.
2. **Check before inserting a cell:** use a multimeter to check there's no short between the holder's + and − pads, or between 3V3 and GND on J2.
3. **First power on USB only:** insert the XIAO, but no cell yet, and plug USB into the XIAO. The charge LED may flicker, because the charger is looking for a battery; that's normal.
4. **Flash the firmware** over USB (see [Firmware](#firmware-esphome-xiao-esp32-c6)).
5. **Insert the cell:** with USB still connected, the charge LED should light while the cell charges and turn off when it's full.
6. **Check the readings:** with USB unplugged, the node should wake, report temperature, humidity and battery voltage, and go back to sleep. The battery voltage in Home Assistant should be within about 0.1 V of a multimeter reading across the cell.

## Adding other sensors
Any 3.3 V I2C sensor breakout can plug into J3 or J5. It shares the bus with the onboard SHTC3 (address 0x70), so its I2C address must not be 0x70. The sensors below all have ESPHome support (platform names checked against the ESPHome docs; each name links to its page), and suit a battery-powered node:

| Sensor | Measures | ESPHome platform | Fit for this board |
|---|---|---|---|
| **SHT40 / SHT45** | Temperature, humidity (more accurate than the SHTC3) | [`sht4x`](https://esphome.io/components/sensor/sht4x.html) | Excellent: fast, microamp current |
| **BME280** | Temperature, humidity, air pressure | [`bme280_i2c`](https://esphome.io/components/sensor/bme280.html) | Excellent |
| **BMP280** | Temperature, air pressure | [`bmp280_i2c`](https://esphome.io/components/sensor/bmp280.html) | Excellent |
| **AHT20** | Temperature, humidity | [`aht10`](https://esphome.io/components/sensor/aht10.html) with `variant: AHT20` | Excellent, low cost |
| **BH1750** | Light level (lux) | [`bh1750`](https://esphome.io/components/sensor/bh1750.html) | Excellent |
| **VEML7700** | Light level, wide range | [`veml7700`](https://esphome.io/components/sensor/veml7700.html) | Excellent |
| **TSL2591** | Light level, high dynamic range | [`tsl2591`](https://esphome.io/components/sensor/tsl2591.html) | Good |
| **LTR390** | UV index and light | [`ltr390`](https://esphome.io/components/sensor/ltr390.html) | Good |
| **SCD40 / SCD41** | CO₂ (true NDIR), temperature, humidity | [`scd4x`](https://esphome.io/components/sensor/scd4x.html) | Works, but set `measurement_mode: single_shot` (each reading takes about 5 s) and a longer `report_delay` (about 7 s). CO₂ sensors draw much more current than the others, so battery life drops noticeably |
| **BME680 / BME688** | Temperature, humidity, pressure, gas (VOC) | [`bme680`](https://esphome.io/components/sensor/bme680.html) | Temperature, humidity and pressure work well. The gas reading needs the sensor powered continuously to stabilize, so it's unreliable when the sensor is switched off between readings |
| **SGP40 / SGP41, ENS160** | Air quality (VOC/NOx) | [`sgp4x`](https://esphome.io/components/sensor/sgp4x.html), [`ens160_i2c`](https://esphome.io/components/sensor/ens160.html) | Not recommended: they need continuous power and a warm-up period, which defeats deep sleep |

**Tips:**
- **Pull-up resistors:** breakouts with their own pull-ups are fine; they sit in parallel with R9 and R10. Breakouts with a power LED waste battery, so cut or remove the LED if you can.
- **5 V-only sensors** such as particulate sensors and most PMS-series modules won't work. The sockets supply 3.3 V only.
- **Config example:** add the sensor to the ESPHome config next to the SHTC3. For example, an SHT40:
  ```yaml
  sensor:
    - platform: sht4x
      temperature:
        name: Temperature (SHT40)
      humidity:
        name: Humidity (SHT40)
      update_interval: 5s
  ```

## Firmware (ESPHome, XIAO ESP32-C6)
A complete ESPHome config is in [`firmware/smart-sensor-xiao-esp32c6.yaml`](firmware/smart-sensor-xiao-esp32c6.yaml). It does the following:

- **Deep sleep:** the node wakes, reads temperature, humidity and battery voltage, reports them, and sleeps again. By default it goes back to sleep 2 s after Home Assistant connects (usually 3–6 s awake in total), sleeps 5 minutes, and never stays awake longer than 20 s; change `report_delay`, `sleep_time` and `awake_time` at the top.
- **Sensor power sequencing:** GPIO18 is driven low at boot priority 1200, before I2C starts (priority 1000), so the sensor and its pull-ups are powered when the bus is set up.
- **No phantom powering:** the ESP32-C6's internal I2C pull-ups are turned off. Just before deep sleep, SDA, SCL and GPIO18 are set to high-impedance with no pulls; R7 then switches the sensor rail off. Nothing can drive the sensor through its data pins while it is unpowered.
- **Lower radio power:** Wi-Fi uses `fast_connect`, light power-save and 15 dB transmit power to shorten and cheapen each wake-up. The regulator handles full power if you need the range.
- **Antenna:** the XIAO's RF switch is enabled with its built-in antenna selected. Set GPIO14 high in the boot lambda to use the U.FL connector.

- **Stay-awake switch:** while `input_boolean.smart_sensor_stay_awake` is on in Home Assistant, the node skips deep sleep so you can update it over the air or watch its logs. It picks the change up the next time it wakes.

### Setting it up in Home Assistant
1. **Install ESPHome:** add the ESPHome Device Builder add-on in Home Assistant (Settings → Add-ons), or use the `esphome` command line on your computer.
2. **Add the secrets:** copy [`firmware/secrets.yaml.example`](firmware/secrets.yaml.example) to `secrets.yaml` and fill in your Wi-Fi details, an API encryption key, an OTA password and a fallback-hotspot password. In the Device Builder, open **Secrets** (top right) and paste the same keys there. `secrets.yaml` is ignored by git, so it won't be committed.
3. **Add the device:** in the Device Builder choose **New device**, skip the wizard, and paste the contents of `smart-sensor-xiao-esp32c6.yaml` into the new device's file. You can change `name`, `sleep_time`, `report_delay` and `awake_time` at the top (see [Adjusting the wake and sleep timing](#adjusting-the-wake-and-sleep-timing)).
4. **First flash over USB:** plug the XIAO into your computer and choose **Install → Plug into this computer** (or run `esphome run smart-sensor-xiao-esp32c6.yaml`). Later updates can go over Wi-Fi.
5. **Add the device to Home Assistant:** wake the sensor (press the XIAO's reset button, or turn on the stay-awake toggle from step 6 first) so it is online, then:
   - **If it's discovered:** go to **Settings → Devices & services**. A "Discovered: smart-sensor" card appears; click **Add**, enter the API encryption key from your `secrets.yaml`, and click **Submit**.
   - **If it isn't discovered:** go to **Settings → Devices & services → Add integration**, search for **ESPHome**, enter `smart-sensor.local` (or the sensor's IP address) as the host with port `6053`, then enter the API encryption key.
   - **Pick an area:** choose where the sensor lives (for example "Bedroom") and click **Finish**.
6. **Add the stay-awake toggle:** copy [`homeassistant/smart_sensor_package.yaml`](homeassistant/smart_sensor_package.yaml) to `<config>/packages/` and add this to `configuration.yaml`, then restart Home Assistant:
   ```yaml
   homeassistant:
     packages:
       smart_sensor: !include packages/smart_sensor_package.yaml
   ```
   To update the firmware later, turn the toggle on, wait for the sensor's next wake-up, install the update, then turn the toggle off.

The node appears with **Temperature**, **Humidity**, **Battery voltage** and **Battery level** entities. Because the config uses deep sleep, ESPHome tells Home Assistant it is a sleeping device, so Home Assistant keeps the last reading between wake-ups instead of marking the sensor unavailable.

### Adjusting the wake and sleep timing

#### How often the sensor wakes up (`sleep_time`)
`sleep_time` sets the time between readings. It is the first thing to change if you want more frequent readings or a longer-lasting battery.

1. **Open the config.** In Home Assistant go to **Settings → Add-ons → ESPHome Device Builder**, then click **Edit** on your Smart Sensor. If you use ESPHome on a computer, open `smart-sensor-xiao-esp32c6.yaml` instead.
2. **Change `sleep_time`** in the `substitutions:` block at the top:

   ```yaml
   substitutions:
     sleep_time: 15min    # wake up and send a reading every 15 minutes
   ```

   Use a number followed by a unit: `s` (seconds), `min` (minutes) or `h` (hours), for example `30s`, `5min`, `15min`, `1h`, `12h`, `24h`. The default is `5min`.
3. **Keep the node awake so it can take the update.** A sleeping node can't receive new firmware. In Home Assistant, turn on the **Smart Sensor stay awake** toggle (`input_boolean.smart_sensor_stay_awake`, from `homeassistant/smart_sensor_package.yaml`), then wait for the node's next wake-up. Its status turns online in the ESPHome dashboard.
4. **Install it.** Click **Save**, then **Install → Wirelessly**. The node restarts with the new interval.
5. **Turn the stay-awake toggle off again.** The node goes back to its normal cycle on its next wake.

The time between readings is `sleep_time` plus the few seconds the node is awake, so `5min` gives a reading roughly every 5 minutes and 5 seconds.

**How the interval affects battery life (rough estimate):**

| `sleep_time` | 18350 (~1100 mAh) | 18650 (~3000 mAh) | 21700 (~4500 mAh) |
|---|---|---|---|
| `1min` | about 1 week | about 3 weeks | about 1 month |
| `5min` (default) | about 1 month | about 3 months | about 5 months |
| `15min` | about 3 months | about 9 months | over a year |
| `30min` | about 6 months | over a year | over a year |
| `1h` | about 11 months | over a year | over a year |
| `12h` | about 3 years* | several years* | several years* |
| `24h` | about 3–4 years* | several years* | several years* |

These figures assume each wake lasts about 5 s at an average of about 68 mA (in line with a tester's PPK2 measurements on the original board, see [Sleep current](#sleep-current)) and about 25 µA while asleep, using 90% of the cell's capacity. Weak Wi-Fi, a slow plug-in sensor, a longer `report_delay` and cold temperatures all shorten battery life. Beyond about a year, the cell's own self-discharge starts to matter more than the board.

\* At 12- and 24-hour intervals, the wake-ups barely matter. Battery life is set by the ~25 µA sleep current and the cell's own self-discharge (typically 1–3% a month), so these figures are rough; check the battery level in Home Assistant now and then and recharge at least once a year. Use `sleep_time: 12h` or `24h` (ESPHome also accepts `720min` or `1440min`). For readings this far apart, a 1-hour reading is usually more useful for temperature and humidity; 12–24 hours suits slow-changing things such as a battery check or a storage-room log.

Suggested intervals: 5–15 minutes for temperature and humidity, 15–60 minutes for soil moisture, and 2–5 minutes for CO₂ in a busy room.

#### How long it stays awake
Each cycle, the node wakes, connects to Wi-Fi and Home Assistant, sends its readings, and goes back to sleep. Three values at the top of `smart-sensor-xiao-esp32c6.yaml` control this:

```yaml
substitutions:
  awake_time: 20s     # safety limit: longest the node stays awake each cycle
  sleep_time: 5min    # how long it sleeps between cycles
  report_delay: 2s    # after Home Assistant connects, wait this long, then sleep
```

**How a cycle ends:** the sensors take their first reading within a couple of seconds of boot, while Wi-Fi is still connecting. When Home Assistant connects, it receives those readings and the state of the stay-awake toggle. `report_delay` later the node sleeps, so a typical wake lasts about 3–6 s. `awake_time` only matters when Wi-Fi or Home Assistant can't be reached: the node then gives up and sleeps after 20 s instead of draining the battery.

**When a sensor needs more time:** a reading only gets sent if it finishes before the node sleeps. If a sensor shows up as unknown or never updates:

1. **Raise `report_delay`** to cover the sensor's measurement time. For example, an SCD40/41 in `single_shot` mode takes about 5 s per reading, so use `report_delay: 7s`.
2. **Raise `awake_time` too** if connection time + `report_delay` comes close to it. Rough rule: connection time (about 5–10 s) + `report_delay` + 5 s of margin.
3. **Make sure the sensor reads during that window.** Its `update_interval` must be shorter than the time the node is awake; the provided config uses `5s`. For a slow sensor, set its `update_interval` to at least its measurement time (for example `10s` for an SCD4x).
4. **Sensors that need a warm-up after power-on:** the sensor rail switches on at the very start of boot (5 ms before I2C starts), so most of the warm-up overlaps with the Wi-Fi connection. If a sensor needs longer, add the extra time to `report_delay`. Sensors that need minutes of warm-up (gas/VOC sensors) won't settle in a short wake window at all; see [Adding other sensors](#adding-other-sensors).

**Sleeping right after one slow sensor reports (alternative):** instead of a fixed `report_delay`, you can sleep as soon as the slowest sensor has a value. Set `report_delay` long (say `30s`) and add:

```yaml
sensor:
  - platform: scd4x
    measurement_mode: single_shot
    update_interval: 10s
    co2:
      name: CO2
      on_value:
        then:
          - delay: 2s                      # let the value reach Home Assistant
          - deep_sleep.enter: deep_sleep_1
```

**Trade-offs:**
- **Battery life** is roughly proportional to awake time ÷ total cycle time, because the ESP32-C6 draws tens of milliamps while awake (more while transmitting) and only microamps asleep. Halving the time awake roughly halves the energy per reading; this is why the node sleeps as soon as its readings are sent.
- **A longer `sleep_time`** is the easiest way to extend battery life. 5 minutes suits temperature and humidity; 10–15 minutes is fine for slowly changing values; CO₂ in a busy room may want 2–5 minutes.
- **Updating the firmware:** turn on the stay-awake toggle in Home Assistant first (see [Setting it up in Home Assistant](#setting-it-up-in-home-assistant)), or temporarily raise `report_delay` and `awake_time`.

### Sleep current
While the XIAO sleeps, the board itself draws only a few microamps: the regulator about 2 µA, the protector about 4 µA, the charger's battery leakage about 1 µA and the divider 0.4 µA. The XIAO's own deep-sleep current comes on top; the ESP32-C6 chip alone is rated at 7 µA.

**Measuring it yourself:** power the board from a source meter in place of the cell (for example a Nordic PPK2 in source mode, set to 3.7–4.0 V) and connect to the battery holder's + and − contacts. Unplug USB while measuring, because USB feeds the charger. Remove plug-in sensor boards that have their own power LED or regulator, because they add their own current. On the original board, one tester measured 380 µA asleep with a soil-moisture sensor attached, and 68 mA average (0.6 A peaks while transmitting) during a 3.45 s wake. If you measure far above the figures here, check the plug-in sensors first.

## Repository layout
```
smart_sensor_battery.kicad_*   18350 board (master design)
BMS.kicad_sch                  battery management sub-sheet
Library.pretty/                footprints for all boards (including the universal holder footprint)
3d_models/                     3D models
variants/18650/                18650 board (KiCad project)
variants/21700/                21700 board (KiCad project)
variants/universal/            universal board: 18350, 18650 or 21700 holder (KiCad project)
tools/make_variant.py          generates the variant boards from the master
tools/make_universal.py        generates the universal board from the 21700 variant
tools/make_case.py             generates the 3D-printable case STLs and previews
tools/make_release.py          builds the per-board release zips (python3 tools/make_release.py 1.0)
case/                          3D-printable case: STL files, preview images and print notes
tools/make_gerbers.py          writes Gerber and drill files without KiCad
tools/make_jlc_bom.py          writes JLCPCB BOM and placement files
firmware/                      ESPHome config and secrets template for the XIAO ESP32-C6
homeassistant/                 Home Assistant package (stay-awake toggle)
docs/images/                   board previews used in this README
gerbers/                       JLCPCB-ready Gerber + drill zips for all four boards
assembly/                      JLCPCB BOM and placement (CPL) files for all four boards
```

## Changing the design
The root (18350) project is the master. Make circuit or layout changes there, then regenerate the larger boards so they pick up the change (Python 3, no extra packages):

```
python3 tools/make_variant.py --name 18650 \
    --footprint Library.pretty/BatteryHolder_Keystone_1042_1x18650.kicad_mod \
    --value 1042 --mpn "Keystone 1042" --neg-y 108.08 --set R1=910

python3 tools/make_variant.py --name 21700 \
    --footprint Library.pretty/BatteryHolder_Keystone_1121_1x21700.kicad_mod \
    --value 1121 --mpn "Keystone 1121" --cell 21700 --set R1=910
python3 tools/make_universal.py   # universal board, built from variants/21700
```

The script swaps the holder, resizes the outline, extends the battery traces, stretches the ground pours and updates BT1 in the schematic. `--set REF=VALUE` overrides a part value in that variant; the larger cells use it to raise the charge current. It also reports any holder hole that would land on existing copper; use `--neg-y` to slide the holder along the board if one does. To add another cell size, point `--footprint` at that holder's KiCad footprint.

The 18650 footprint comes from the official KiCad library (CC-BY-SA 4.0 with the KiCad library exception), with its pads renamed P/N to match the BT1 symbol.

## ⚠️ Safety Warning
This board involves **Lithium-Ion battery charging**. 
*   This is an **experimental prototype** from a hobbyist. **I am not a professional engineer**. It has **not** been certified by safety agencies (UL, CE, etc.).
*   Lithium batteries can be dangerous if mishandled (risk of thermal runaway, fire, explosion, and serious injury).
*   **DO NOT leave this device unattended with a battery connected**
*   By using these files, you agree that you are solely responsible for verifying the safety of the circuit.

## License & Liability

### 1. Non-Commercial Use Only
This project is shared under the [Creative Commons Attribution-NonCommercial-ShareAlike 4.0 International](https://creativecommons.org/licenses/by-nc-sa/4.0/) license.
*  **You are free to:** Download, modify, and build this for personal use or learning.
*  **You may NOT:** Sell this board, use it in a product you sell, or use these files for any commercial purpose.
*  If you modify and share this design, you must share it under this same license.

### 2. No Liability (Disclaimer)
These files are provided "As Is" for educational purposes ONLY. I am sharing my personal project notes. **I accept no liability for any damage, injury, or loss** that occurs from the use or assembly of these files. Use them at your own risk.

## Credits
Original design, schematic, layout and video by [FeatureNAB](https://github.com/FeatureNAB/smart-sensor-battery-pack). This fork's changes are listed under [Changes from the original design](#changes-from-the-original-design) and are shared under the same CC BY-NC-SA 4.0 license, as the original requires.
