allenrobberson/smart-sensor-battery-pack/case/images/case-18350-section.png

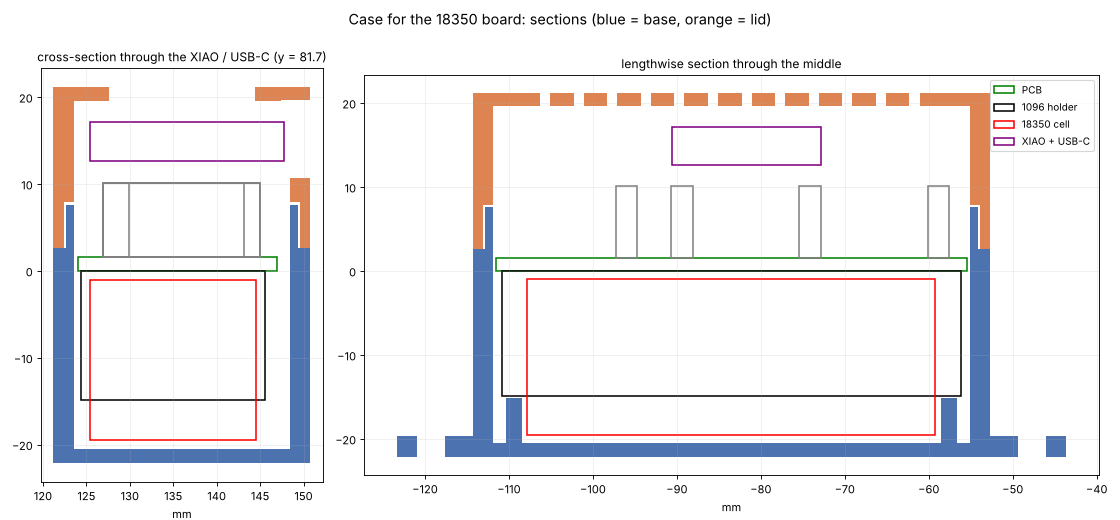
case/images/case-18350-section.png
