allenrobberson/smart-sensor-battery-pack/case/images/case-18350.png

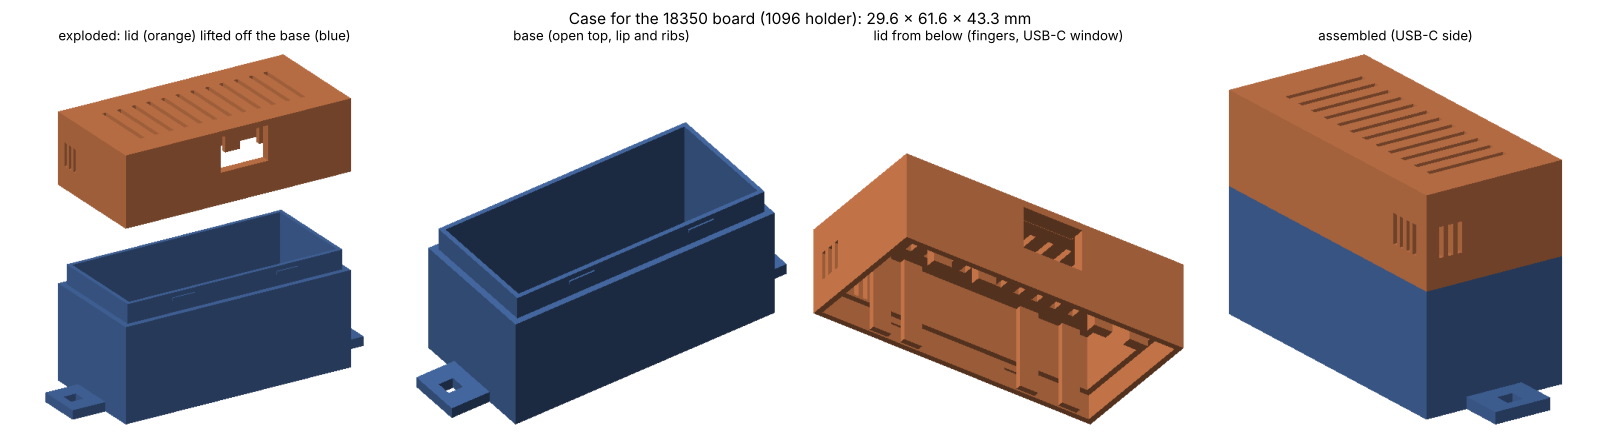
case/images/case-18350.png
