allenrobberson/smart-sensor-battery-pack/case/images/case-21700-section.png

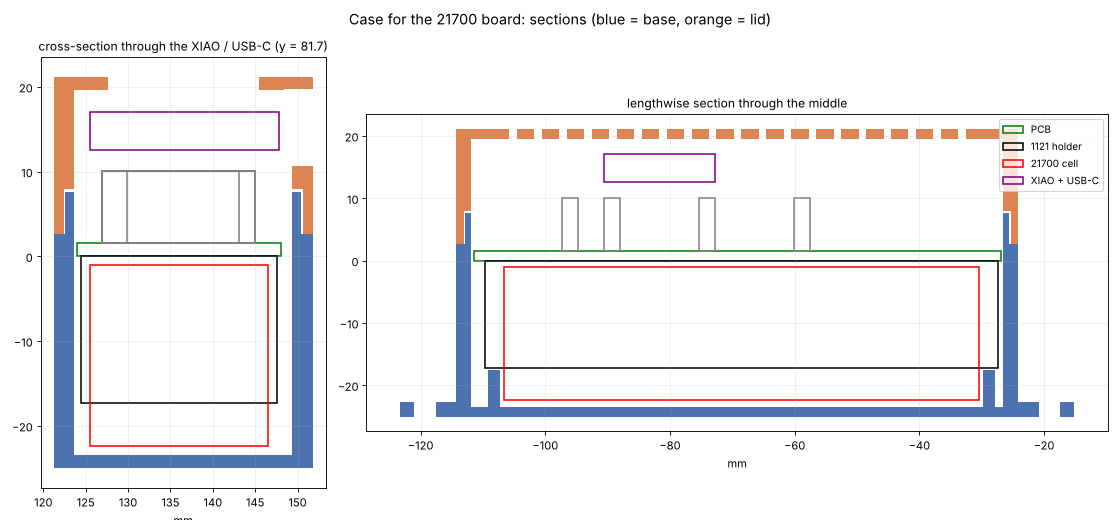
case/images/case-21700-section.png
