allenrobberson/smart-sensor-battery-pack/case/images/case-universal-18350-section.png

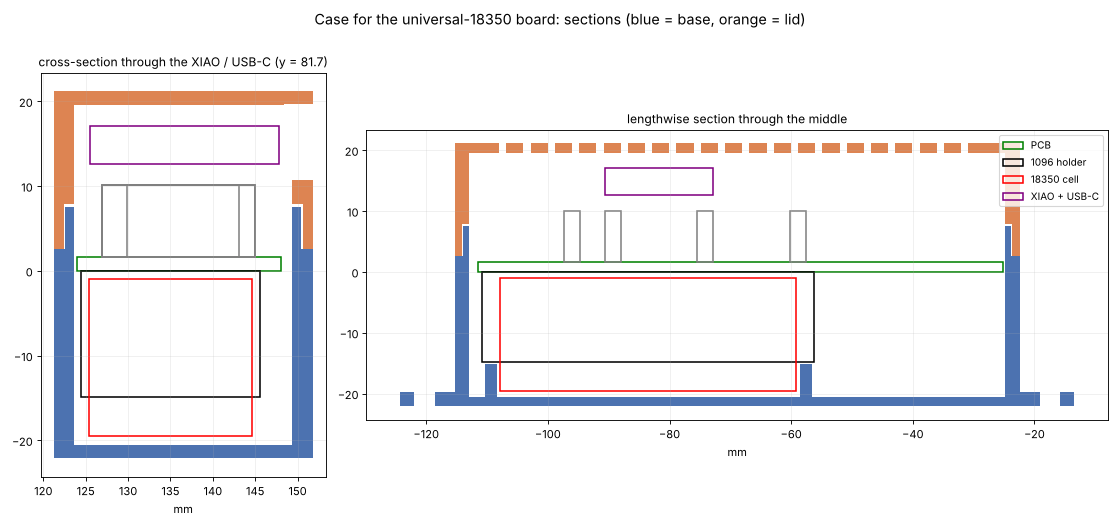
case/images/case-universal-18350-section.png
