allenrobberson/smart-sensor-battery-pack/assembly/SSB-UNIVERSAL-BOM.csv

Comment | Designator | Footprint | LCSC Part #
2.2uF@16v | C1,C2 | C_0603_1608Metric | C23630
10uF@10v | C3 | C_0603_1608Metric | C19702
100nF@16v | C4,C5,C6 | C_0402_1005Metric | C1525
LED | D1 | LED_0402_1005Metric | C74339
Lower MCU Socket / Sensor Socket / Upper MCU Socket | J1,J2,J3 | PinSocket_1x07_P2.54mm_Vertical_SMD | C42379199
5-pin Socket | J5 | PinSocket_1x05_P2.54mm_Vertical_SMD_Pin1Left | C42379198
AO3401A | Q1,Q2 | SOT-23 | C15127
1k | R1 | R_0402_1005Metric | C11702
10k NTC | R2 | R_0402_1005Metric | C77131
2.2k | R3,R8 | R_0402_1005Metric | C25879
330 | R4 | R_0402_1005Metric | C25104
5.1M | R5,R6,R11,R12 | R_0402_1005Metric | C26092
100k | R7 | R_0402_1005Metric | C25741
10k | R9,R10 | R_0402_1005Metric | C25744
BQ21040DBV | U2 | SOT-23-6 | C202311
RT9080-33GJ5 | U4 | SOT-23-5 | C841192
BQ29700 | U5 | WSON-6_1.5x1.5mm_P0.5mm | C183096
CSD85301Q2 | U6 | CSD85301Q2 | C544396
SHTC3 | U7 | Sensirion_DFN-4-1EP_2x2mm_P1mm_EP0.7x1.6mm | C194656
