allenrobberson/smart-sensor-battery-pack/case/stl/case-universal-18650-base.stl

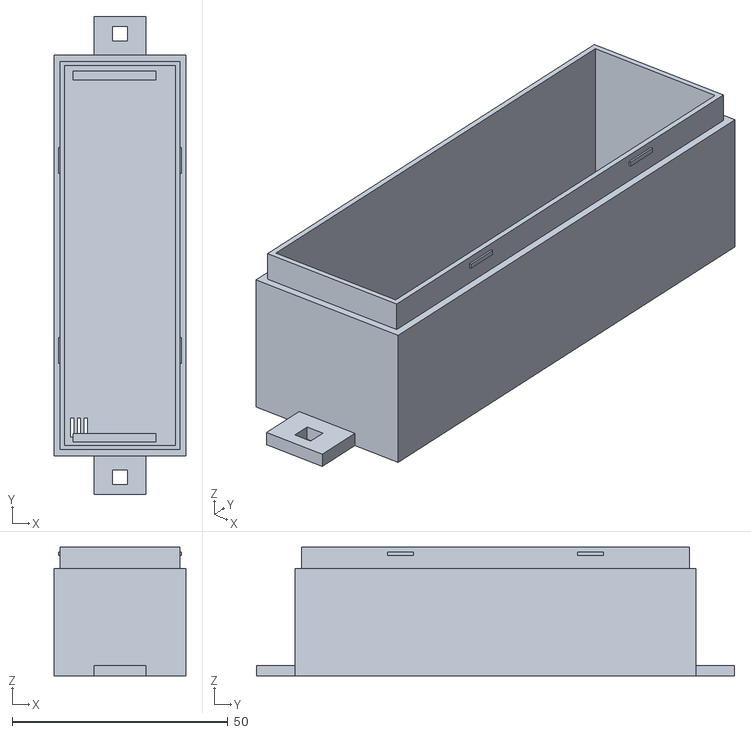
[picture p14: CAD file, 2026-11-12]
case/stl/case-universal-18650-base.stl
30.6 x 110.8 x 29.9
