allenrobberson/smart-sensor-battery-pack/case/stl/case-universal-21700-base.stl

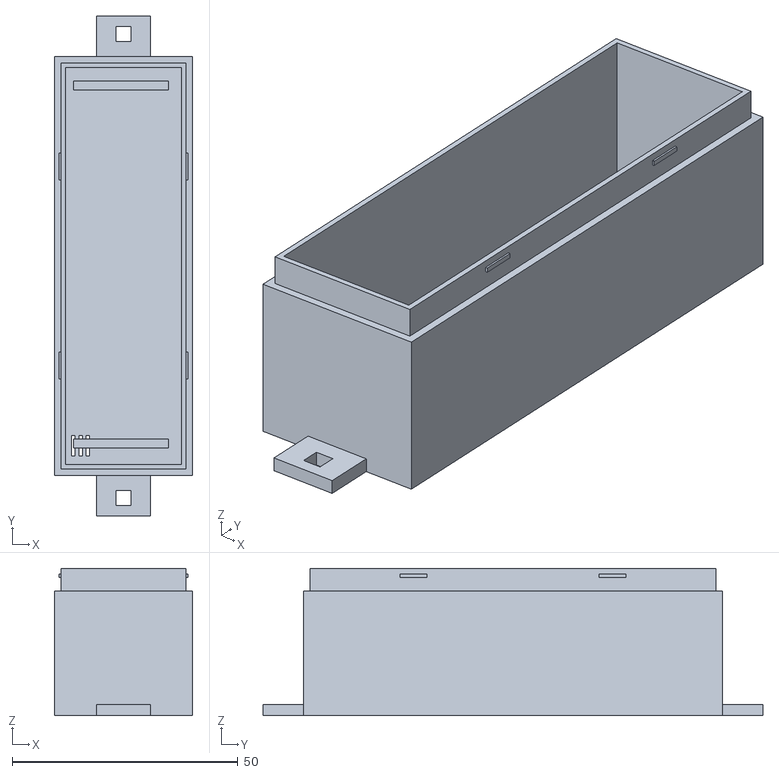
[picture p15: CAD file, 2026-11-12]
case/stl/case-universal-21700-base.stl
30.6 x 110.8 x 32.6
