allenrobberson/smart-sensor-battery-pack/case/stl/case-18350-base.stl

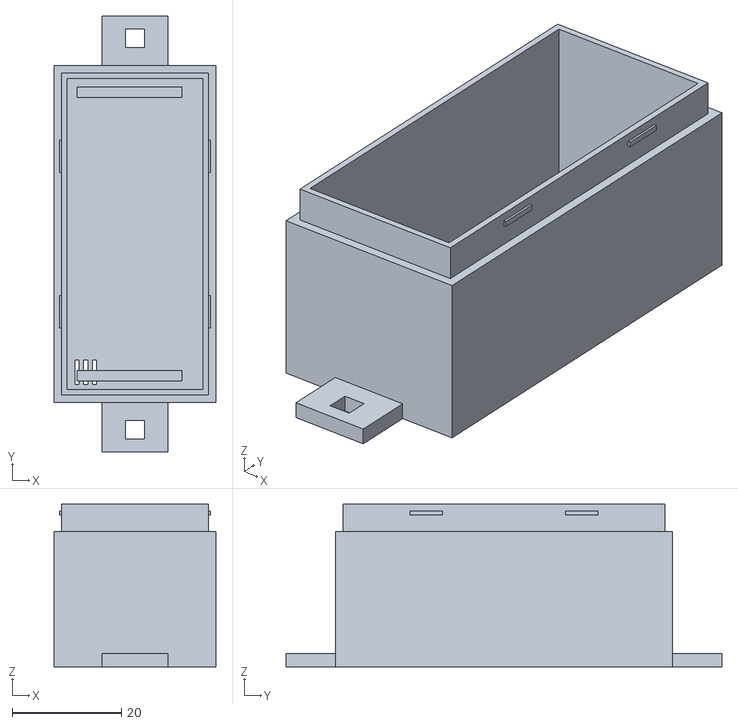
[picture p16: CAD file, 2026-11-12]
case/stl/case-18350-base.stl
29.6 x 79.6 x 29.7
