allenrobberson/smart-sensor-battery-pack/case/stl/case-21700-base.stl

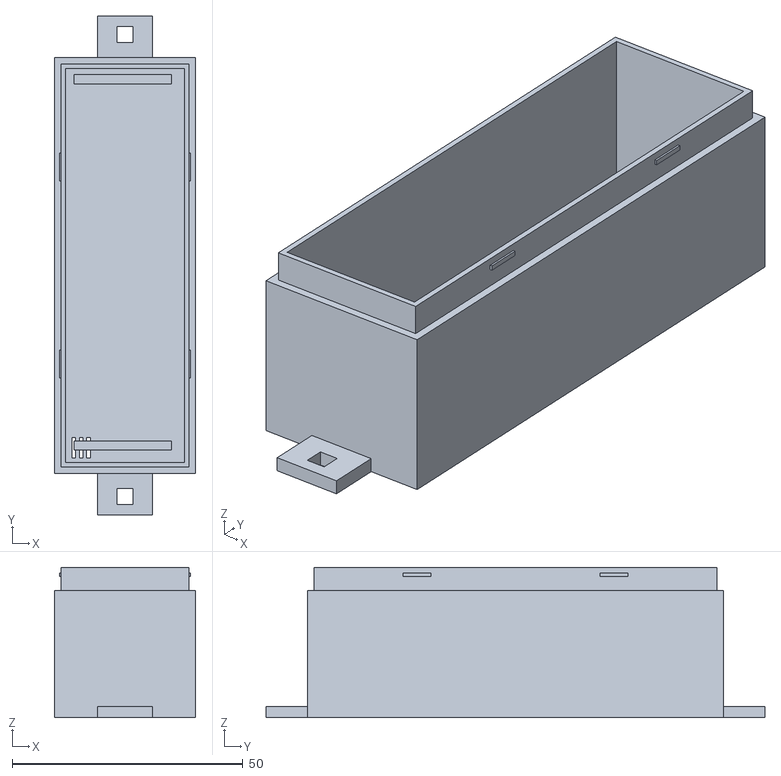
[picture p17: CAD file, 2026-11-12]
case/stl/case-21700-base.stl
30.6 x 108.2 x 32.6
