allenrobberson/smart-sensor-battery-pack/case/stl/case-universal-18350-base.stl

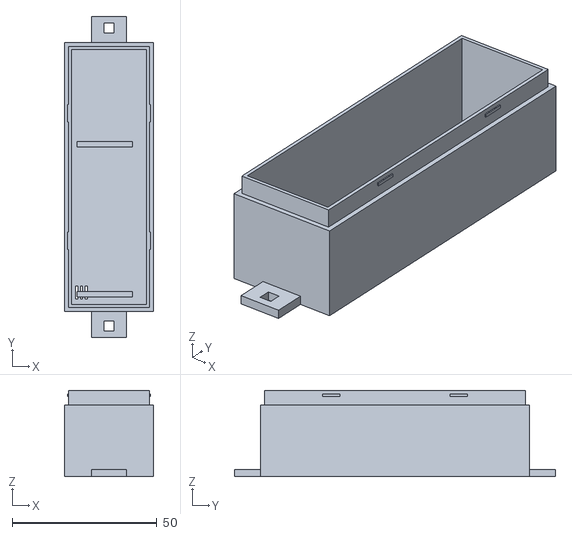
[picture p18: CAD file, 2026-11-12]
case/stl/case-universal-18350-base.stl
30.6 x 110.8 x 29.7
