allenrobberson/smart-sensor-battery-pack/case/stl/case-18650-base.stl

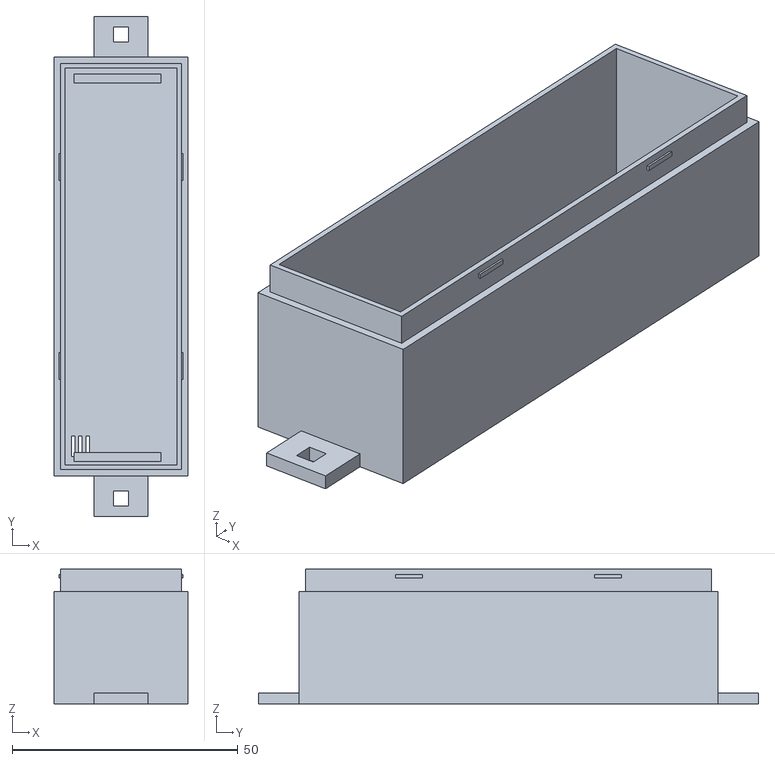
[picture p19: CAD file, 2026-11-12]
case/stl/case-18650-base.stl
29.6 x 110.8 x 29.9
