allenrobberson/smart-sensor-battery-pack/case/stl/case-21700-lid.stl

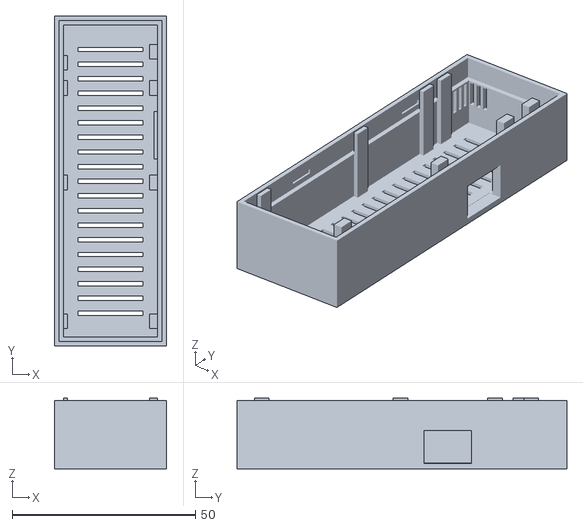
[picture p20: CAD file, 2026-11-12]
case/stl/case-21700-lid.stl
30.6 x 90.2 x 19.3
