allenrobberson/smart-sensor-battery-pack/case/stl/case-18650-lid.stl

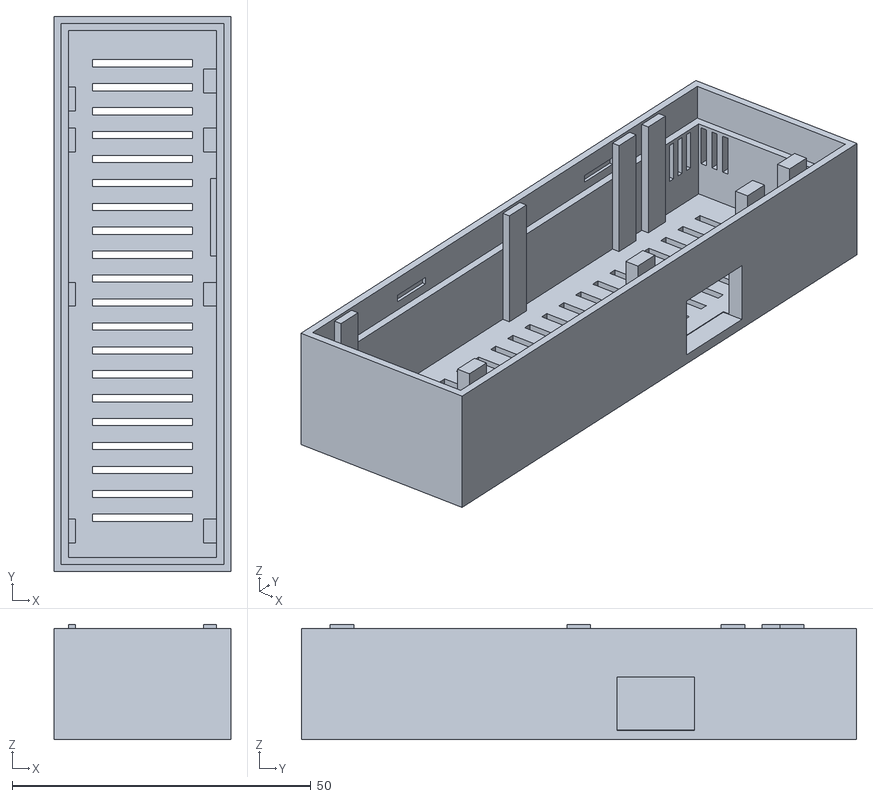
[picture p21: CAD file, 2026-11-12]
case/stl/case-18650-lid.stl
29.6 x 92.8 x 19.3
