allenrobberson/smart-sensor-battery-pack/case/stl/case-18350-lid.stl

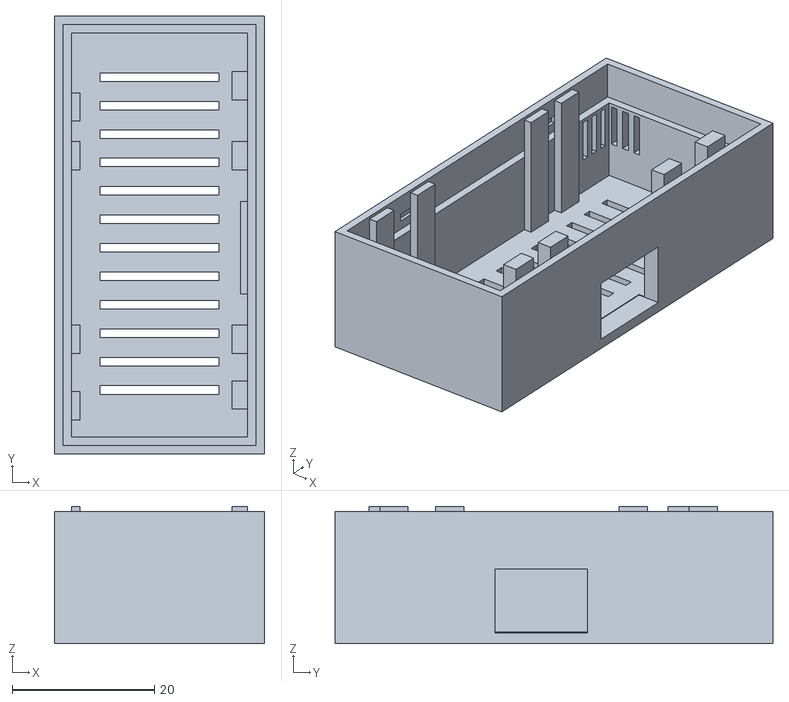
[picture p22: CAD file, 2026-11-12]
case/stl/case-18350-lid.stl
29.6 x 61.6 x 19.3
