allenrobberson/smart-sensor-battery-pack/case/stl/case-universal-lid.stl

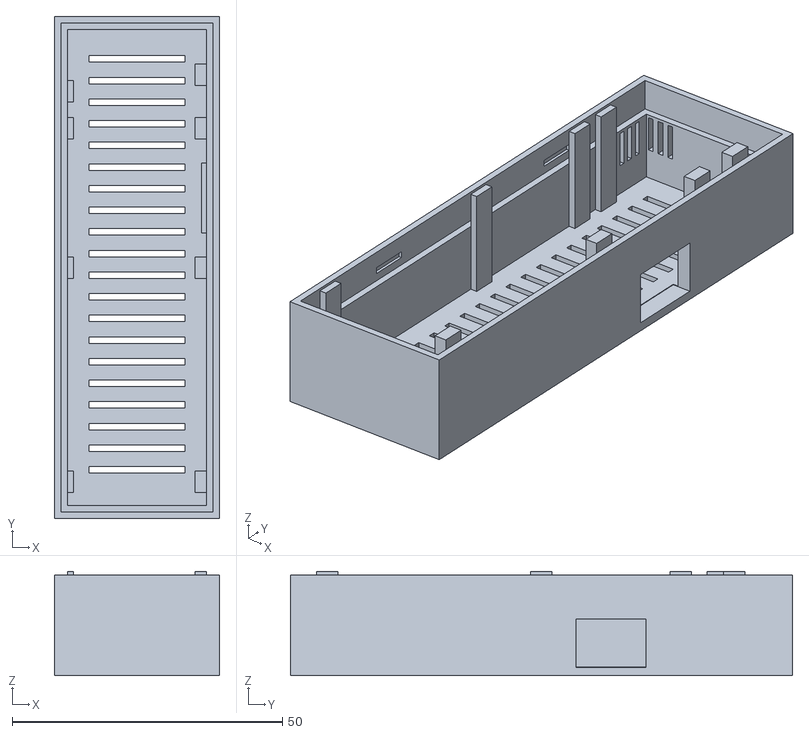
[picture p23: CAD file, 2026-11-12]
case/stl/case-universal-lid.stl
30.6 x 92.8 x 19.3
