allenrobberson/smart-sensor-battery-pack/variants/universal/smart_sensor_battery.kicad_pcb

## KiCad design variants/universal/smart_sensor_battery.kicad_pcb (2026-11-12)

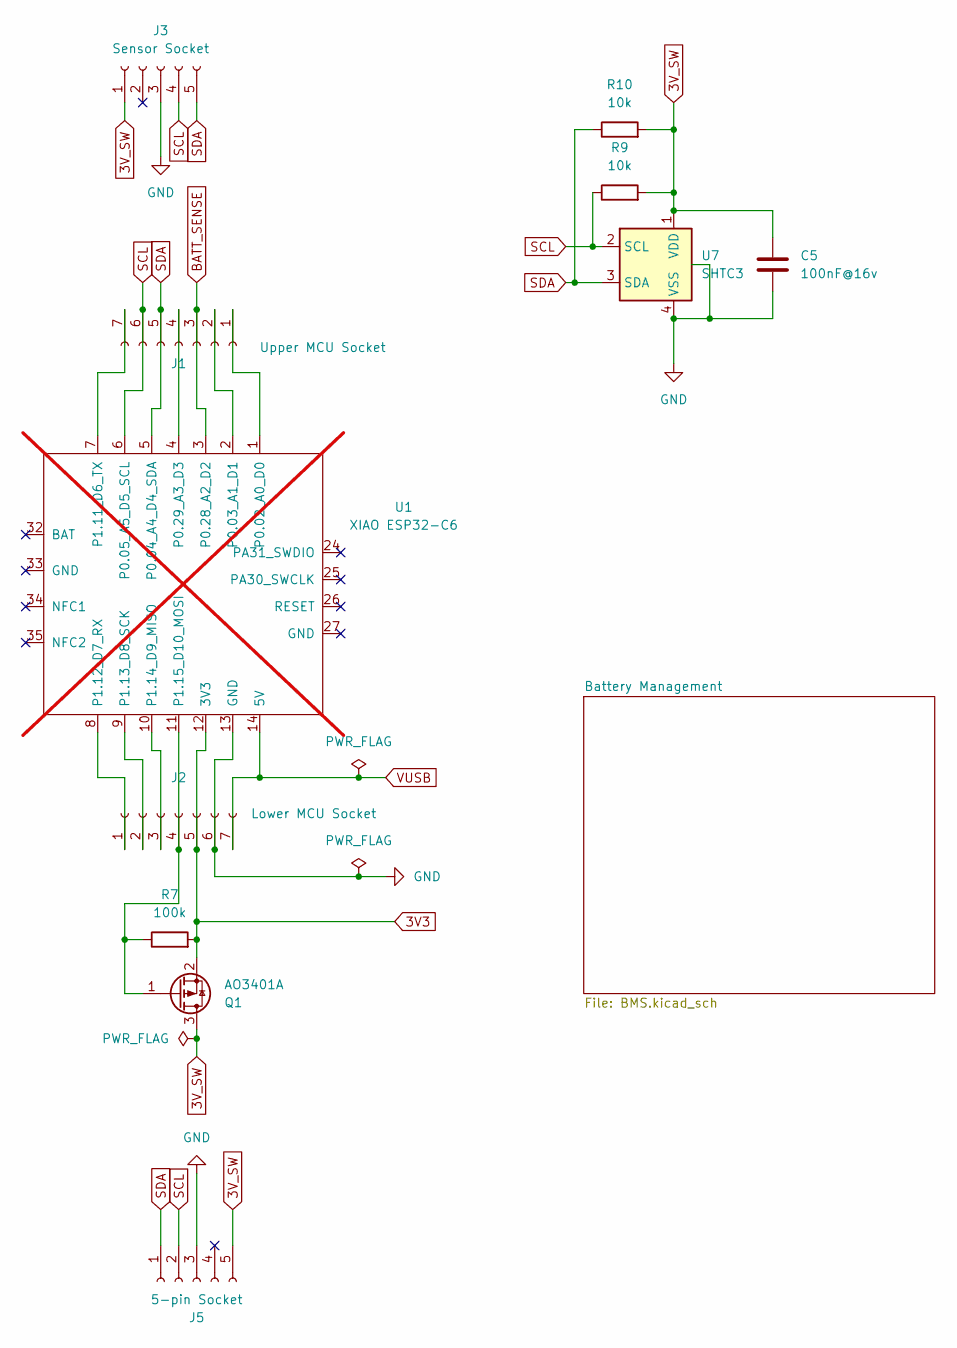
[picture p24: schematic smart_sensor_battery.kicad_sch, Plant Sensor Breakout Board]

Parts:
C5: 100nF@16v; C_0402_1005Metric; LCSC Part no. C1525
J1: Upper MCU Socket; PinSocket_1x07_P2.54mm_Vertical_SMD_Pin1Left; LCSC Part no. C42379199
J2: Lower MCU Socket; PinSocket_1x07_P2.54mm_Vertical_SMD_Pin1Right; LCSC Part no. C42379199
J3: Sensor Socket; PinSocket_1x07_P2.54mm_Vertical_SMD_Pin1Right; LCSC Part no. C42379199
J5: 5-pin Socket; PinSocket_1x05_P2.54mm_Vertical_SMD_Pin1Left; LCSC Part no. C42379198
Q1: AO3401A; SOT-23; LCSC Part no. C15127
R7: 100k; R_0402_1005Metric; LCSC Part no. C25741
R9, R10: 10k; R_0402_1005Metric; LCSC Part no. C25744
U1: XIAO ESP32-C6; XIAO-nRF52840-SMD; not fitted
U7: SHTC3; Sensirion_DFN-4-1EP_2x2mm_P1mm_EP0.7x1.6mm; LCSC Part no. C194656

Connections:
3V3: J2.5, Q1.2 (S), R7.2, U1.12 (3V3); also elsewhere on the board
3V_SW: C5.1, J3.1, J5.5, Q1.3 (D), R9.2, R10.2, U7.1 (VDD)
BATT_SENSE: J1.3, U1.3 (P0.28_A2_D2); also elsewhere on the board
GND: C5.2, J2.6, J3.3, J5.3, U1.13 (GND), U7.4 (VSS), U7.5 (GND_(centre_pad)); also elsewhere on the board
unnamed: J1.1, U1.1 (P0.02_A0_D0)
unnamed: J1.2, U1.2 (P0.03_A1_D1)
unnamed: J1.4, U1.4 (P0.29_A3_D3)
unnamed: J1.7, U1.7 (P1.11_D6_TX)
unnamed: J2.1, U1.8 (P1.12_D7_RX)
unnamed: J2.2, U1.9 (P1.13_D8_SCK)
unnamed: J2.3, U1.10 (P1.14_D9_MISO)
unnamed: J2.4, Q1.1 (G), R7.1, U1.11 (P1.15_D10_MOSI)
SCL: J1.6, J3.4, J5.2, R9.1, U1.6 (P0.05_A5_D5_SCL), U7.2 (SCL)
SDA: J1.5, J3.5, J5.1, R10.1, U1.5 (P0.04_A4_D4_SDA), U7.3 (SDA)
VUSB: J2.7, U1.14 (5V); also elsewhere on the board

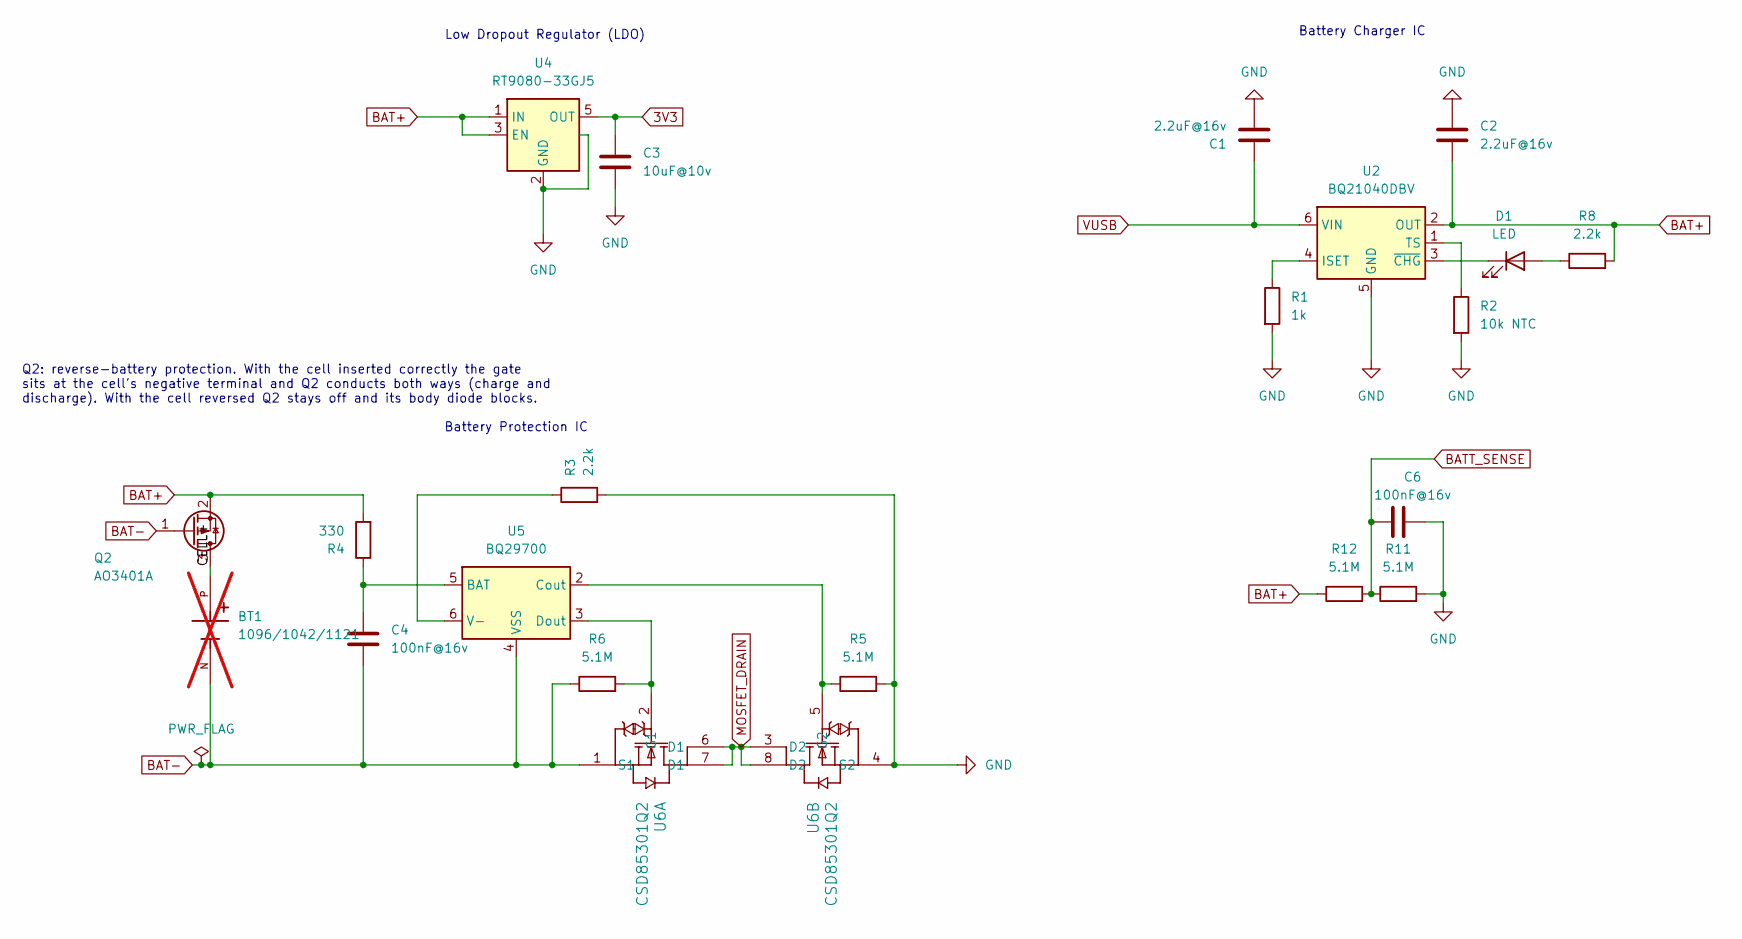
[picture p25: schematic BMS.kicad_sch]

Parts:
BT1: 1096/1042/1121; BatteryHolder_Universal_18350_18650_21700; PARTREV A; not fitted
C1, C2: 2.2uF@16v; C_0603_1608Metric; LCSC Part no. C23630
C3: 10uF@10v; C_0603_1608Metric; LCSC Part no. C19702
C4, C6: 100nF@16v; C_0402_1005Metric; LCSC Part no. C1525
D1: LED; LED_0402_1005Metric; LCSC Part no. C74339
Q2: AO3401A; SOT-23; LCSC Part no. C15127
R1: 1k; R_0402_1005Metric; LCSC Part no. C11702
R2: 10k NTC; R_0402_1005Metric; MPN Murata NCP15XH103F03RC; LCSC Part no. C77131
R3, R8: 2.2k; R_0402_1005Metric; LCSC Part no. C25879
R4: 330; R_0402_1005Metric; LCSC Part no. C25104
R5, R6, R11, R12: 5.1M; R_0402_1005Metric; LCSC Part no. C26092
U2: BQ21040DBV; SOT-23-6; LCSC Part no. C202311
U4: RT9080-33GJ5; SOT-23-5; MPN Richtek RT9080-33GJ5; LCSC Part no. C841192
U5: BQ29700; WSON-6_1.5x1.5mm_P0.5mm; LCSC Part no. C183096
U6: CSD85301Q2; LCSC Part no. C544396

Connections:
3V3: C3.1, U4.5 (OUT); also elsewhere on the board
BAT+: C2.1, Q2.2 (S), R4.2, R8.2, R12.1, U2.2 (OUT), U4.1 (IN), U4.3 (EN)
BAT-: BT1.N, C4.2, Q2.1 (G), R6.1, U5.4 (VSS), U6.1 (S1)
BATT_SENSE: C6.1, R11.1, R12.2; also elsewhere on the board
CELL+: BT1.P, Q2.3 (D)
GND: C1.2, C2.2, C3.2, C6.2, R1.2, R2.2, R3.2, R5.2, R11.2, U2.5 (GND), U4.2 (GND), U4.4 (NC_(GND)), U6.4 (S2); also elsewhere on the board
MOSFET_DRAIN: U6.3 (D2), U6.6 (D1), U6.7 (D1), U6.8 (D2)
unnamed: D1.2 (A), R8.1
unnamed: D1.1 (K), U2.3 (~CHG)
unnamed: R1.1, U2.4 (ISET)
unnamed: R2.1, U2.1 (TS)
unnamed: C4.1, R4.1, U5.5 (BAT)
unnamed: R5.1, U5.2 (Cout), U6.5 (G2)
unnamed: R6.2, U5.3 (Dout), U6.2 (G1)
unnamed: R3.1, U5.6 (V-)
VUSB: C1.1, U2.6 (VIN); also elsewhere on the board

Notes on the sheet:
Battery Protection IC
Battery Charger IC
Low Dropout Regulator (LDO)
Q2: reverse-battery protection. With the cell inserted correctly the gate sits at the cell's negative terminal and Q2 conducts both ways (charge and discharge). With the cell reversed Q2 stays off and its body diode blocks.

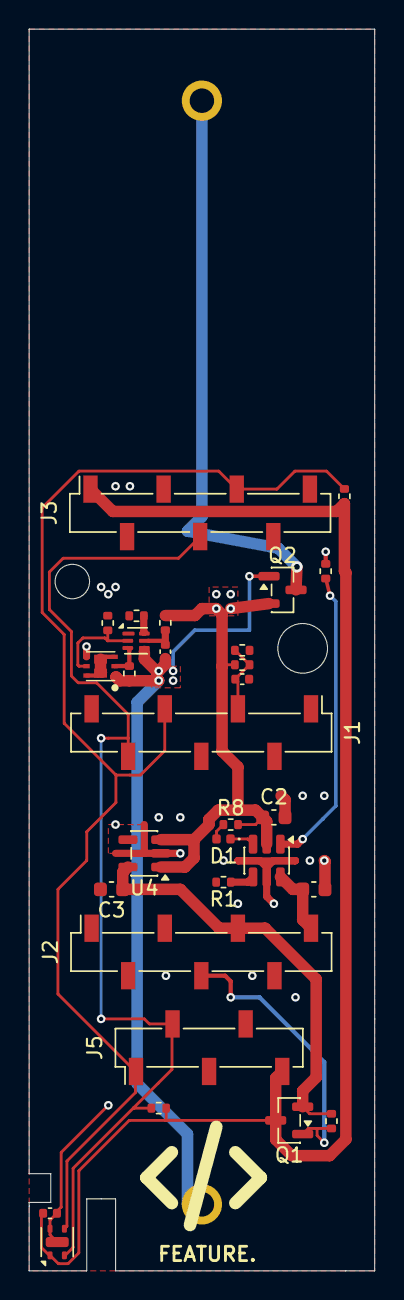
[picture p26: board smart_sensor_battery.kicad_pcb from above]

Board: 2 copper layers, 24.0 x 86.2 mm, 31 parts (1 on the bottom side), 20 nets.
