allenrobberson/smart-sensor-battery-pack/(commit log)

2026-11-11 Add 18650 board variant and battery-size variant generator
    - tools/make_variant.py: builds variants/<cell>/ from the 18350 master,
    swapping the back-side holder, lengthening/widening the outline,
    extending the BAT+/BAT- traces, stretching GND pours and updating BT1
    in the schematic. Reports locating-hole clashes with existing copper.
    - variants/18650: Keystone 1042 holder, 23 x 86.25 mm board.
    - Library.pretty: Keystone 1042 footprint (from the KiCad library).
    - README: variant table and regeneration instructions.
    Claude-Session: https://claude.ai/code/session_01XYnVL1FYSQQSzAWwnejohZ
    [BMS.kicad_sch, smart_sensor_battery.kicad_pcb, smart_sensor_battery.kicad_sch]
2026-11-11 Add 21700 board variant (Keystone 1121 holder)
    - Library.pretty: Keystone 1121 footprint drawn from drawing 1121 rev A.
    - variants/21700: 24 x 84.55 mm board; holder lugs, pegs and the
    extra locating hole all clear existing copper.
    - make_variant.py: support through-hole holder lugs, size the outline
    from the holder body too, ignore same-net copper in the lug check.
    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
    [BMS.kicad_sch, smart_sensor_battery.kicad_pcb, smart_sensor_battery.kicad_sch]
2026-11-11 README: correct the I2C pull-up note
    The design already has 10k pull-ups (R9, R10), but on the switched
    3V_SW rail, so the remaining requirement is turning Q1 on before I2C
    initialises. Internal pull-ups are now only needed on older boards.
    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
2026-11-11 README: describe the project and all three board designs
    Rewritten README with a project overview, a comparison of the 18350,
    18650 and 21700 boards with front/back previews, build notes, the
    firmware note, repo layout and how to regenerate variants.
    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
2026-11-11 Add reverse-battery protection, NTC, 600 mA LDO and ESP32-C6 firmware
    Hardware (all three boards):
    - Q2 AO3401A P-FET in series with the cell + terminal, gate to BAT-,
    new CELL+ net; reversed cell is blocked.
    - R2 is now a 10k NTC (Murata NCP15XH103F03RC), moved to the corner
    away from the charger; TS rerouted on B.Cu.
    - U4 TPS7A05 (200 mA) -> RT9080-33GJ5 (600 mA, 2 uA Iq), pin-compatible,
    for ESP32-C6 Wi-Fi peaks; C3 2.2 uF -> 10 uF.
    - 18650/21700: R1 910R (~590 mA) so charging fits the 10 h timer.
    - Schematic: Q2 added in the BMS sheet, values/MPNs updated, U1 is
    XIAO ESP32-C6.
    Tools/firmware/docs:
    - make_variant.py: --set REF=VALUE overrides.
    - firmware/smart-sensor-xiao-esp32c6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
    [BMS.kicad_sch, smart_sensor_battery.kicad_pcb, smart_sensor_battery.kicad_sch]
2026-11-11 Add Home Assistant setup: secrets template, stay-awake toggle
    - Firmware: API encryption key and OTA password from secrets, fallback
    hotspot, Home Assistant stay-awake switch that pauses deep sleep.
    - firmware/secrets.yaml.example and .gitignore for the real secrets.
    - homeassistant/smart_sensor_package.yaml: input_boolean for the toggle.
    - README: step-by-step Home Assistant setup.
    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
2026-11-11 README: detailed steps to add the sensor to Home Assistant
    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
2026-11-11 README: clarify how sleeping sensors appear in Home Assistant
    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
2026-11-11 Add Gerber files for all three boards and a KiCad-free Gerber generator
    - tools/make_gerbers.py: writes copper (with pours built from Gerber
    clear polarity), mask, paste, silkscreen outlines, edge cuts and
    PTH/NPTH Excellon drill files straight from .kicad_pcb.
    - gerbers/: JLCPCB-ready zips for 18350, 18650 and 21700. Rasterized
    copper checked: no shorts, no opens, all items on copper.
    - README: ordering section, copper preview, limitations vs a KiCad export.
    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
2026-11-11 Add JLCPCB assembly files (BOM + CPL) for all three boards
    - tools/make_jlc_bom.py: BOM grouped by value/footprint/LCSC number and
    CPL placement file, from the schematic LCSC fields and board positions.
    - assembly/: BOM and CPL for 18350, 18650 and 21700 (battery holder
    excluded, hand-soldered).
    - Schematics: LCSC numbers for RT9080 (C841192), 10 uF (C19702),
    NTC (C77131), SHTC3 (C194656), 910R (C4129882) on the larger boards.
    - README: assembly section with part table and ordering notes.
    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
    [BMS.kicad_sch, SSB-18350-BOM.csv, SSB-18650-BOM.csv, SSB-21700-BOM.csv, smart_sensor_battery.kicad_sch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]
2026-11-11 README: battery holder note, where to buy each holder, soldering tips
    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
2026-11-11 README: battery holders link to DigiKey only
    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
2026-11-11 README: quick start, pinout, batteries, assembly checks, sensor options
    - Quick start: the full path from picking a board to Home Assistant.
    - Connector pinout for J1/J2 (XIAO) and the J3/J5 sensor sockets.
    - Battery guidance and charge times; assembly and first power-up checks.
    - Compatible plug-in I2C sensors with ESPHome platforms and how well
    each suits a deep-sleep, switched-power node.
    - Firmware: commented example for adding a sensor.
    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
2026-11-11 README: link sensor platforms to ESPHome docs, exact SCD4x setting
    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
2026-11-11 README: how to adjust wake/sleep timing for slower sensors
    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
2026-11-11 BOM: one line per LCSC part (JLCPCB rejects duplicate matches)
    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
    [SSB-18350-BOM.csv, SSB-18650-BOM.csv, SSB-21700-BOM.csv]
2026-11-11 CPL: JLCPCB rotation offsets verified in placement preview
    Sockets, SOT-23 (Q1/Q2), SOT-23-5 (U4), SOT-23-6 (U2) and SHTC3 (U7)
    now land on their pads with pin 1 matching the board.
    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
    [SSB-18350-CPL.csv, SSB-18650-CPL.csv, SSB-21700-CPL.csv]
2026-11-11 BOM: in-stock R1 for 18650/21700, basic part for R7
    R1 910 ohm C4129882 is out of stock at JLCPCB; use Uniroyal
    0402WGF9100TCE (C44933, 1%). R7 100k moves to basic part C25741 (1%)
    to drop an extended-part fee.
    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
    [BMS.kicad_sch, SSB-18350-BOM.csv, SSB-18650-BOM.csv, SSB-21700-BOM.csv, smart_sensor_battery.kicad_sch]
2026-11-11 README: tested JLCPCB order settings, prices and cost tips
    Records the exact settings and files used for the November 2026 order
    of all three boards (Economic PCBA on lead-free HASL), the quoted
    prices, the R1/R7 part changes, and ways to lower the cost.
    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
2026-11-11 README: full JLCPCB cost breakdown, shipping and coupons
    Per-board fee breakdown, per-unit cost, the three-board total with
    shipping, and which coupons to use.
    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
2026-11-11 Address original issue #1: sleep after reporting, I2C notes
    - Firmware: sleep report_delay (2 s) after Home Assistant connects
    instead of a fixed 20 s awake; awake_time is now a safety limit.
    The stay-awake toggle still keeps the node up.
    - Firmware: 5 ms settle after switching the sensor rail on, before I2C.
    - Static IP comment: one tester measured it slower, so measure first.
    - README: how each point raised in FeatureNAB issue #1 is handled
    (pull-ups on 3V_SW, internal pull-ups, power sequencing, sleep
    current, Edge.Cuts, polarity marks), and how to measure sleep current.
    Claude-Session: https://claude.ai/code/session_01XYnVL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
    [smart-sensor-xiao-esp32c6.yaml]
2026-11-11 README: how to set the wake-up interval, with battery-life estimates
    Step-by-step for changing sleep_time (including the stay-awake toggle
    needed for OTA to a sleeping node) and a rough battery-life table per
    cell size and interval.
    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
2026-11-11 README: 12 h and 24 h wake intervals in the battery-life table
    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
2026-11-12 Add universal board: one PCB for 18350, 18650 or 21700 holders
    variants/universal: the 21700 board lengthened to 86.25 x 24 mm with a
    combined BT1 footprint on the back:
    - BAT- pad covering the 1096 and 1042 contacts, with the 1121 lug hole
    - BAT+ pads for the 1042/1121 (top) and the 1096 (30.7 mm lower),
    joined by the masked B.Cu trace
    - locating holes for all three holders; overlapping ones merged into slots
    - large +/- marks and cell sizes on the back silkscreen
    - R1 = 1k (C11702, basic), about 540 mA for every cell size
    make_gerbers.py: support slotted (oval) holes (Excellon G85); output for
    the existing boards is byte-identical.
    Adds Gerbers, JLCPCB BOM/CPL, a preview image and READM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
    [BMS.kicad_sch, SSB-UNIVERSAL-BOM.csv, smart_sensor_battery.kicad_pcb, smart_sensor_battery.kicad_sch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]
2026-11-12 README: include the universal board throughout
    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
2026-11-12 README: real order costs, universal board quote and verification status
    - Actual three-board order: $227.72 + $64.13 shipping + $79.73 US duties
    and taxes + $4.44 fee = $376.02 (the cart's shipping estimate was $31.69).
    - Universal board quoted at $72.87 for 5 assembled boards.
    - Assembly Remark box can be missing; raise the U6 note at File Review.
    - What has and hasn't been verified on the universal board.
    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
2026-11-12 CPL: rotate U6 (CSD85301Q2) to 90 deg to match JLCPCB's footprint
    JLCPCB's C544396 footprint has the pins in rows with pin 1 bottom-left at
    0 deg; the KiCad footprint has them in columns. At 180 deg the part was
    turned 90 deg on its pads. Verified in JLCPCB's placement preview: pin 1
    now at the silkscreen dot and the leads on the pads. All other parts
    re-checked; all four boards share identical placement data.
    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
    [SSB-18350-CPL.csv, SSB-18650-CPL.csv, SSB-21700-CPL.csv, SSB-UNIVERSAL-CPL.csv]
2026-11-12 Add 3D-printable case for every board size
    case/: base + lid STLs for the 18350, 18650 and 21700 boards, and three
    bases (one per holder) plus a shared lid for the universal board, with
    preview renders, cross-sections and print notes.
    tools/make_case.py builds the case from boxes on an exact grid
    (watertight, small STLs) and checks it against the PCB, holder, cell,
    every part courtyard, sockets, XIAO, the USB-C plug path and the space
    for plug-in sensors. Features: USB-C window, SHTC3 vents, roof vents,
    snap lip, board hold-down fingers, wall-mount tabs.
    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
    [case-18350-base.stl, case-18350-lid.stl, case-18650-base.stl, case-18650-lid.stl, case-21700-base.stl, case-21700-lid.stl, case-universal-18350-base.stl, case-universal-18650-base.stl]
2026-11-12 Case images: all four cases with the lid lifted off the base
    cases-overview.png shows the 18350, 18650, 21700 and universal cases at
    one scale, each with the lid above its base and a gap between them.
    Per-case previews now open with an exploded view (lid above base), then
    the base, the lid from below and the assembled case, in two colours.
    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
2026-11-12 Add release builder and download note for v1.0
    tools/make_release.py builds one self-contained zip per board option.
    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
